spicydonkey/ecdl/bryce/ecdl-topview.pdf

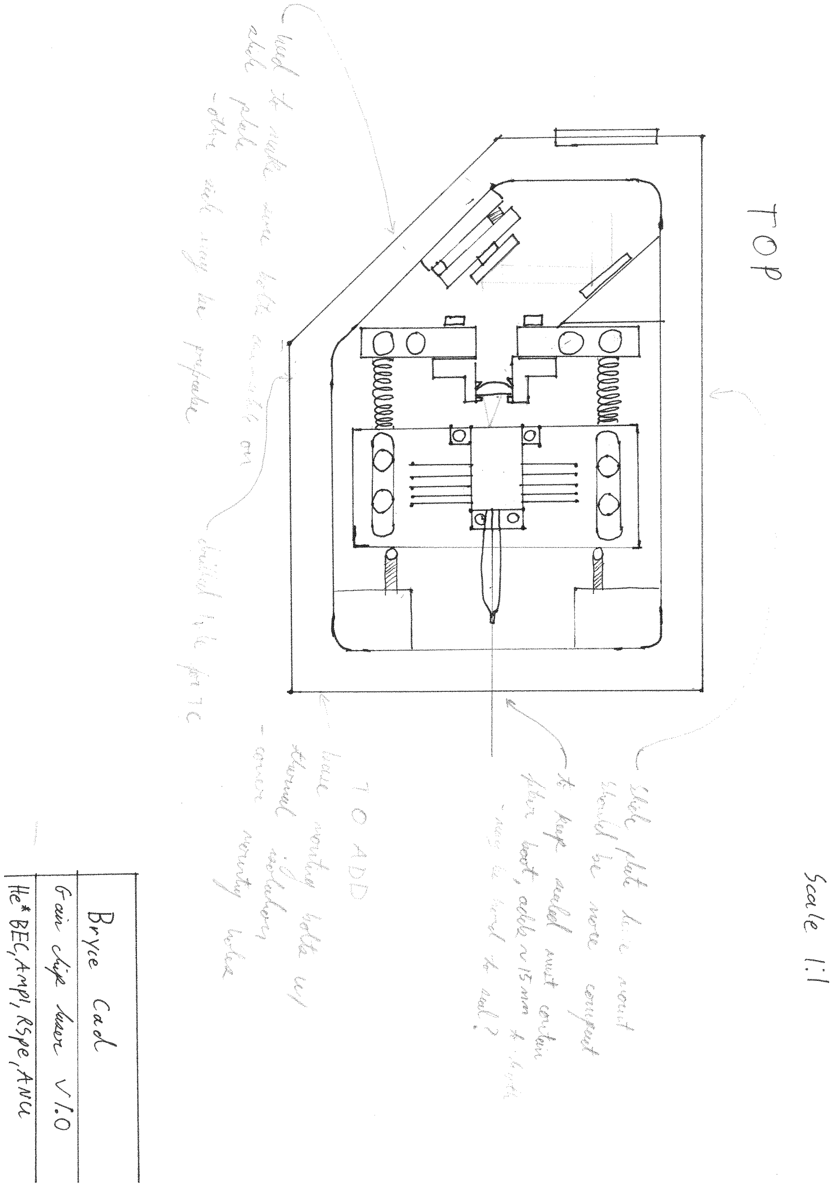
[picture p1: page 1]
