spicydonkey/ecdl/bryce/gc_mount.pdf

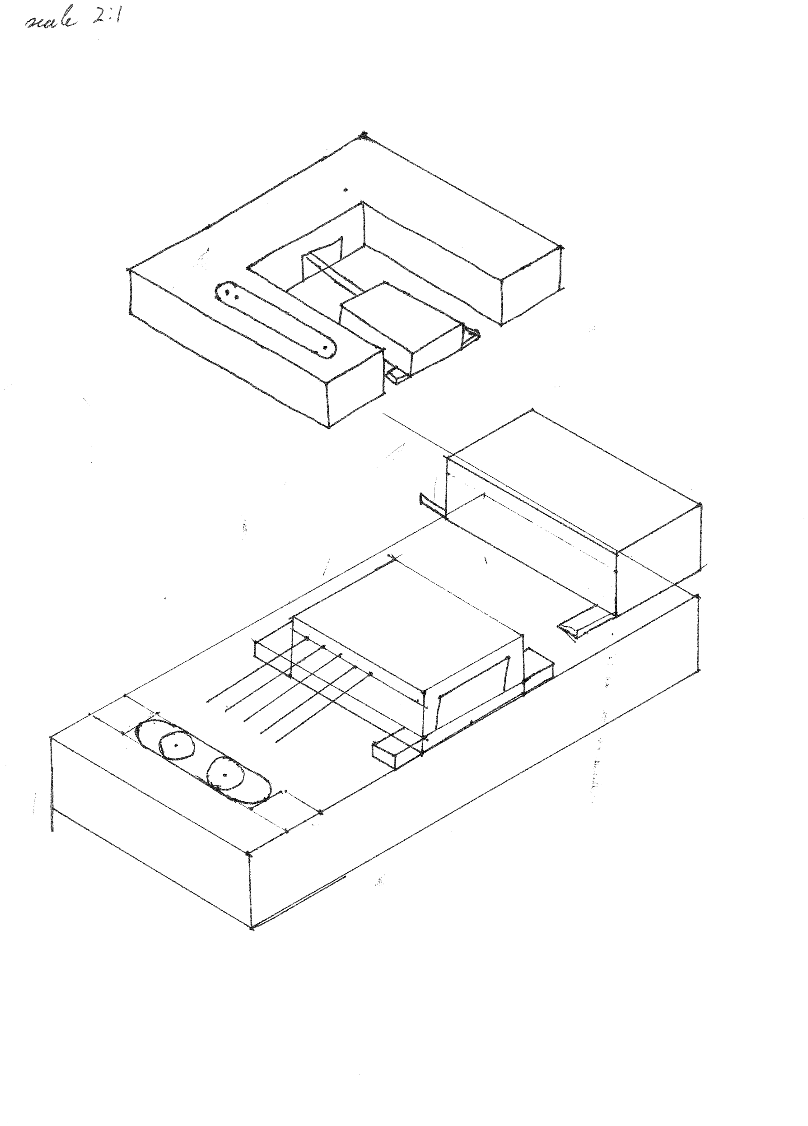
[picture p2: page 1]
