spicydonkey/ecdl/bryce/iso.pdf

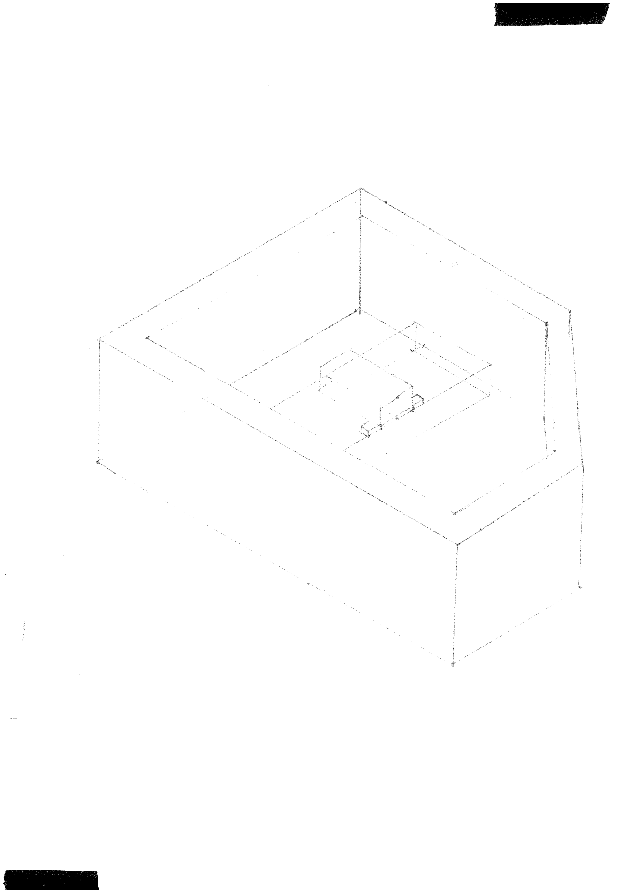
[picture p3: page 1]
