spicydonkey/ecdl/docs/bom.xlsx

Bill of Materials
Product code | Description | Supplier | Amount | Price
PISO-64-2-C-7-2-FB | Polarization maintaining isolator, 1064, dual, 3mm cable jacket, 0.75m fiber, slow axis working and fast axis blocked | AFW | 1 | 260 | 260
KMSS_M | Compact Kinematic Mirror Mount, Hex Adjuster, M4 Taps for Post Mounting | Thorlabs | 1 | 34.3 | 34.3
POLARIS-K05 | Polaris™ Low Drift Ø1/2" Mirror Mount, 3 Low-Profile Hex Adjusters | Thorlabs | 1 | 133 | 133
C240TME-1064 | f = 8.07 mm, NA = 0.5, Mounted Geltech Aspheric Lens, AR: 1064 nm | Thorlabs | 1 | 85.5 | 85.5
WW11050-C14 | Wedged N-BK7 Laser Window, 1dia, AR Coated: 1047 - 1064 nm | Thorlabs | 1 | 120 | 120
GR13-1210 | Ruled reflective diffraction grating, 1200/mm, 1um blaze, 12.7x12.7x6mm | Thorlabs | 1 | 65 | 65
PA4FK | 4 xPiezo chip, 150V, 3.6um, bare electrodes | Thorlabs | 2 | 31 | 62
PCh150/10x10/2 | 10x10x2mm piezo chip, >3um (bipolar) | Piezomechanik | 1 | 150 | 150
 | Lens accessory |  |  |  | 0
 | Fiber connectors |  |  |  | 0
 | Electrical connectors |  |  |  | 0
 |  |  |  |  | 0
 |  |  |  |  | 0
 |  |  |  | Total | 909.8
