spicydonkey/ecdl/B03/outsource/main_block_all.STEP

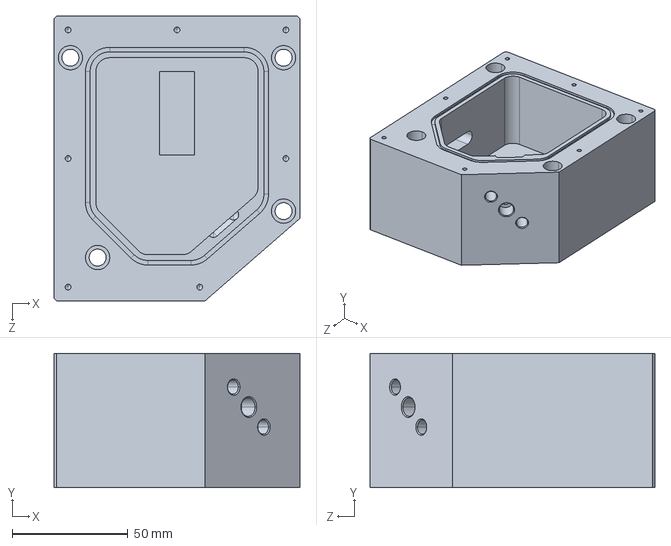
[picture p4: CAD file, 2015-10-12]
B03/outsource/main_block_all.STEP
106.0 x 58.0 x 123.0 mm
