spicydonkey/ecdl/B03/ecdl.SLDASM

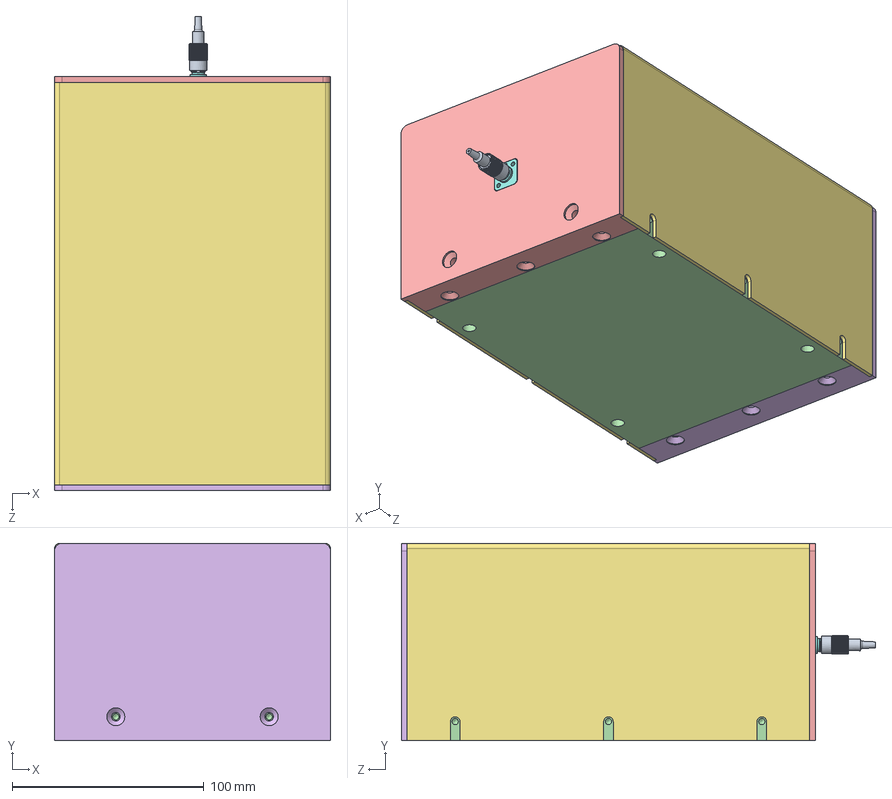
[picture p5: CAD file, 2015-10-22]
B03/ecdl.SLDASM
144.0 x 103.0 x 247.3 mm
ecdl_block
gainchip_mount
B03_KMSS_M-Solidworks_1_02
B03_GR13-1210-Solidworks_02
B03_PCh150-10x10-2
B03_WW11050-C14-Solidworks_02
B03_gainchip_02
fibre_cable_grip^ecdl
lens_tube^ecdl
B03_C240TME-1064-Solidworks
block lid^ecdl
base^ECDL casing_ecdl
front_wall^ECDL casing_ecdl
back_wall^ECDL casing_ecdl
folded_lid^ECDL casing_ecdl
ADAFCPM2-Solidworks
30080K1-Solidworks x 2
APH-127-10-25-S x 2
62GB-12E14-12PN(416)
62GB-56T14-12SN(416)_env
insulating mat^ecdl
fibre_storage_reel
FSRmount
