spicydonkey/ecdl/CAD/B03.SLDASM

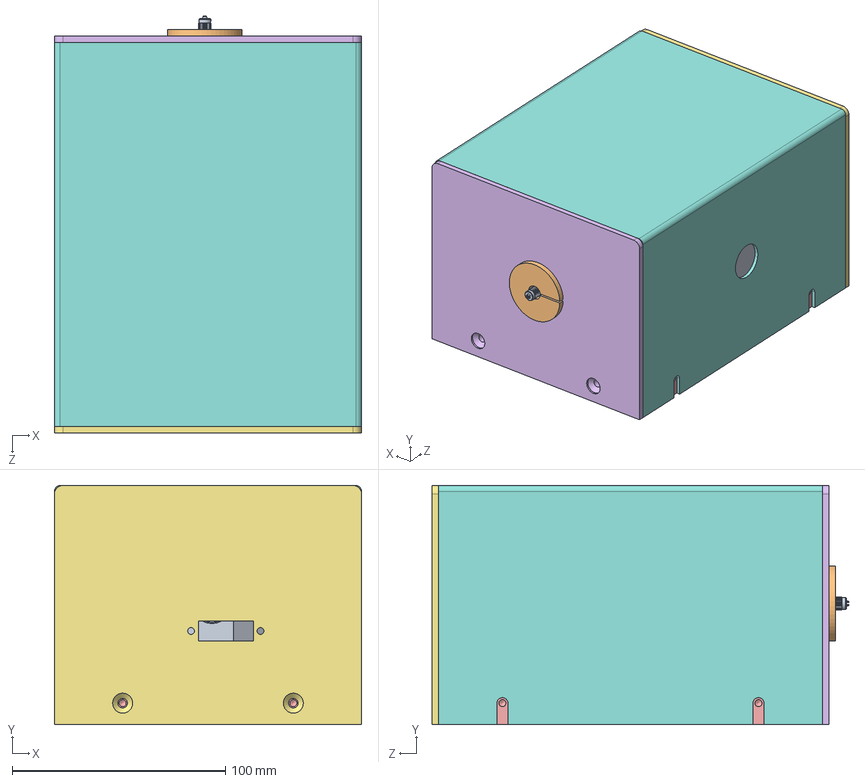
[picture p7: CAD file, 2015-09-30]
CAD/B03.SLDASM
144.0 x 112.0 x 195.4 mm
B03_B01_block_02
gainchip_mount^B03
B03_KMSS_M-Solidworks_1_02
B03_GR13-1210-Solidworks_02
B03_PCh150-10x10-2
B03_WW11050-C14-Solidworks_02
B03_gainchip_02
fibre_cable_grip^B03
lens_tube^B03
B03_C240TME-1064-Solidworks
TEC^B03
