spicydonkey/ecdl/CAD/B02.SLDASM

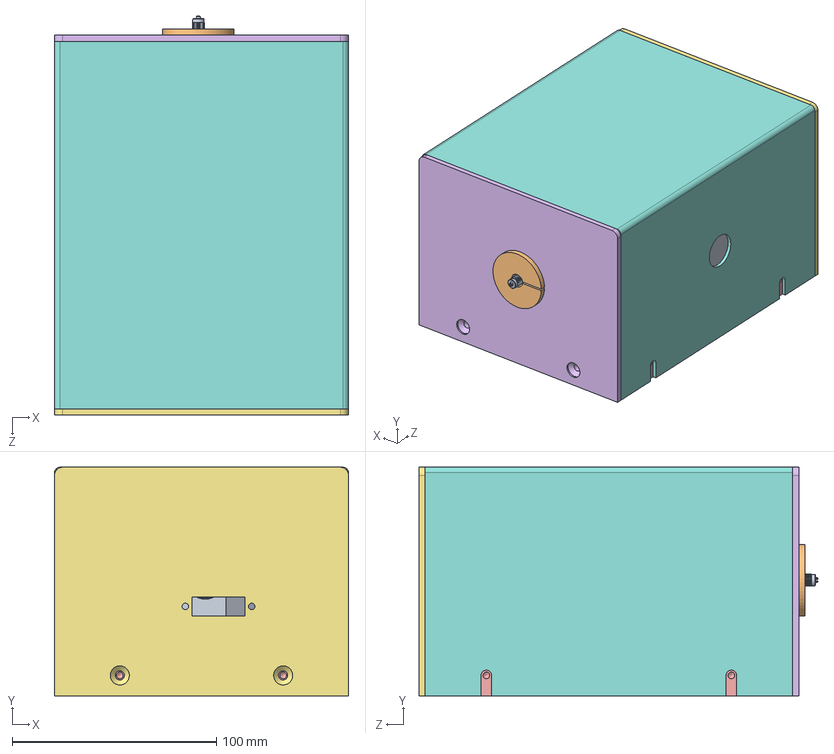
[picture p8: CAD file, 2015-09-29]
CAD/B02.SLDASM
144.0 x 112.0 x 195.4 mm
B01_block_02
B01_XY_bracket^B02
KMSS_M-Solidworks_1_02
GR13-1210-Solidworks_02
PCh150-10x10-2
WW11050-C14-Solidworks_02
gainchip_02
fibre_cable_grip^B02
lens_tube^B02
C240TME-1064-Solidworks
block lid^B02
