spicydonkey/ecdl/CAD/bare_fiber_chuck.SLDASM

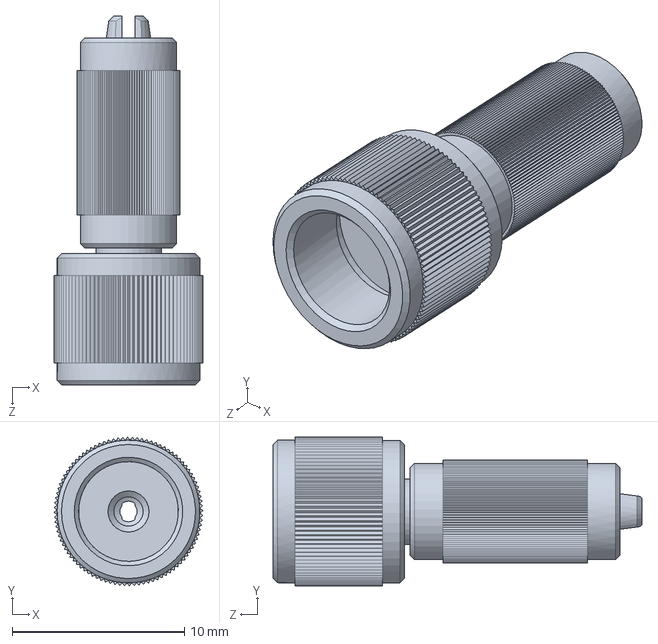
[picture p9: CAD file, 2015-09-28]
CAD/bare_fiber_chuck.SLDASM
8.64 x 8.64 x 21.4 mm
