spicydonkey/ecdl/CAD/grating_sub_02.SLDASM

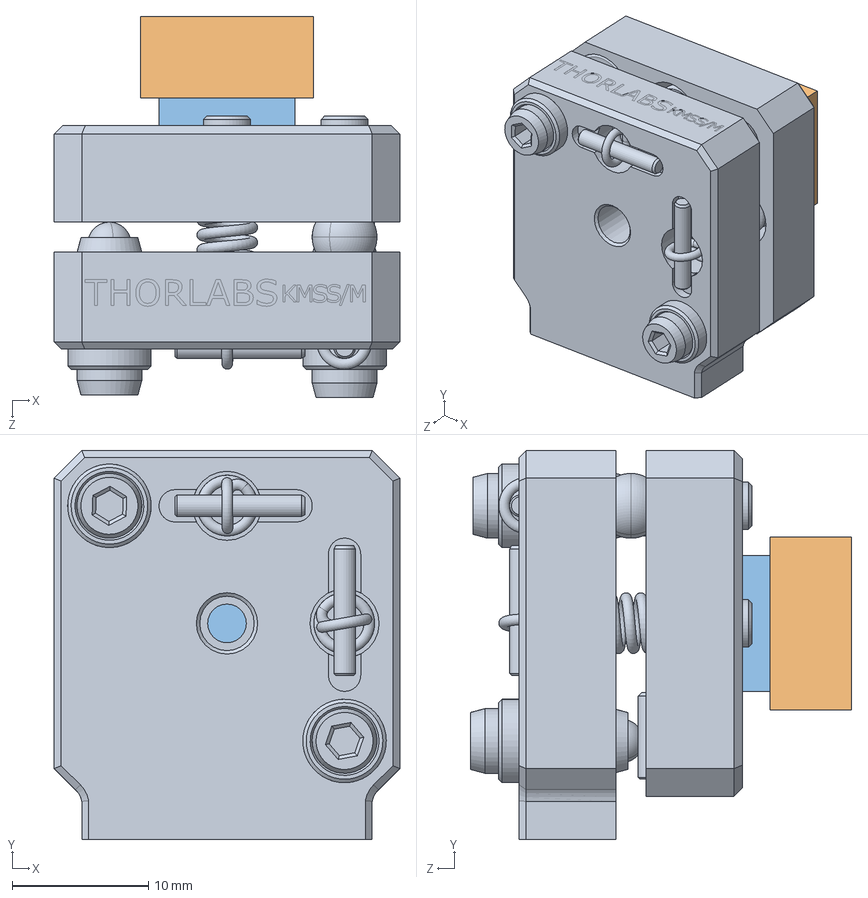
[picture p10: CAD file, 2015-09-26]
CAD/grating_sub_02.SLDASM
25.4 x 28.6 x 28.0 mm
KMSS_M-Solidworks_1_02
GR13-1210-Solidworks_02
PCh150-10x10-2
