spicydonkey/ecdl/CAD/B01_mock.SLDASM

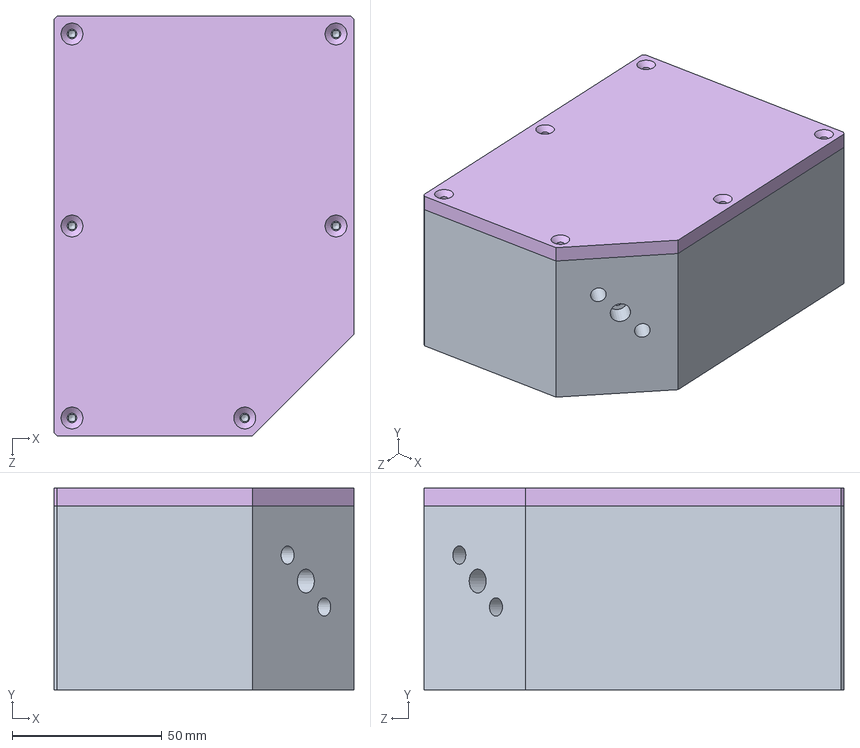
[picture p11: CAD file, 2015-09-25]
CAD/B01_mock.SLDASM
100.0 x 67.3 x 140.0 mm
B01_block
B01_gainchip_mount
gainchip
B01_slip_plate
lens_tube_05
B01_block_lid
KMSS_M-Solidworks_1
PA4FK-Solidworks
GR13-1210-Solidworks
B01_XY_bracket^B01_mock
WW11050-C14-Solidworks
