spicydonkey/ecdl/CAD/B01_gainchip.SLDASM

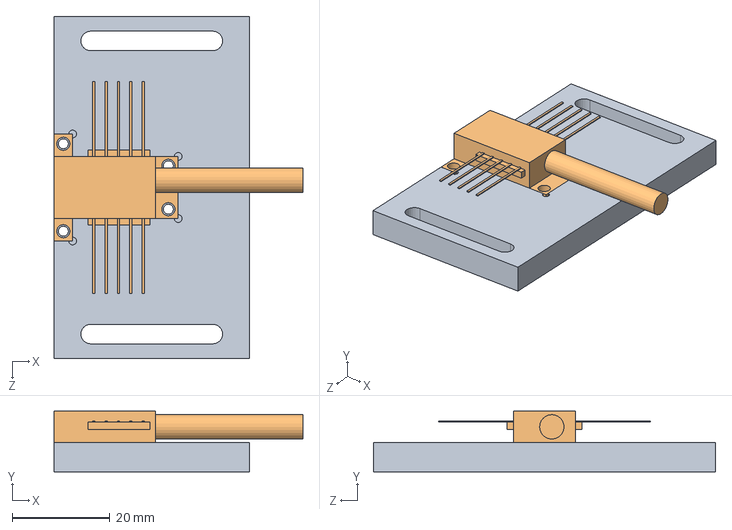
[picture p12: CAD file, 2015-09-25]
CAD/B01_gainchip.SLDASM
51.0 x 12.4 x 70.0 mm
B01_gainchip_mount
gainchip
