spicydonkey/ecdl/CAD/B01_lens_02.SLDASM

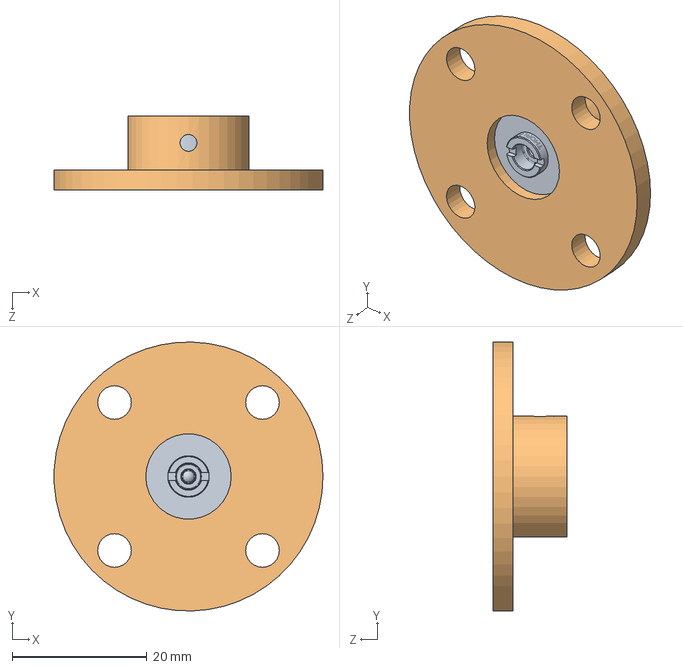
[picture p13: CAD file, 2015-09-24]
CAD/B01_lens_02.SLDASM
40.0 x 40.0 x 11.0 mm
B01_slip_plate_02
lens_tube_05_02
