spicydonkey/ecdl/CAD/B01_gainchip_02.SLDASM

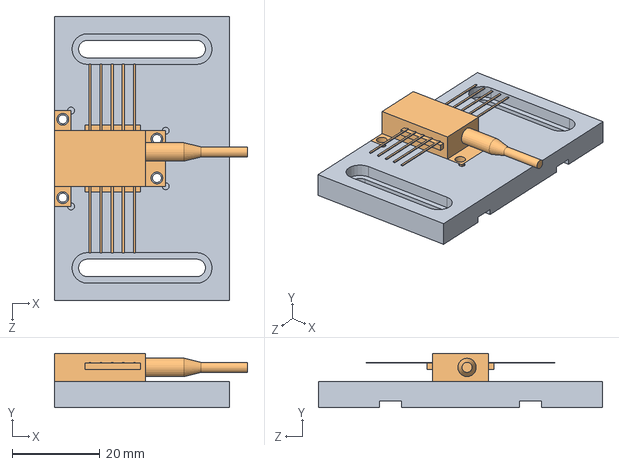
[picture p14: CAD file, 2015-09-24]
CAD/B01_gainchip_02.SLDASM
44.1 x 12.4 x 65.0 mm
B01_gainchip_mount_02
gainchip_02
