spicydonkey/ecdl/CAD/D02.SLDASM

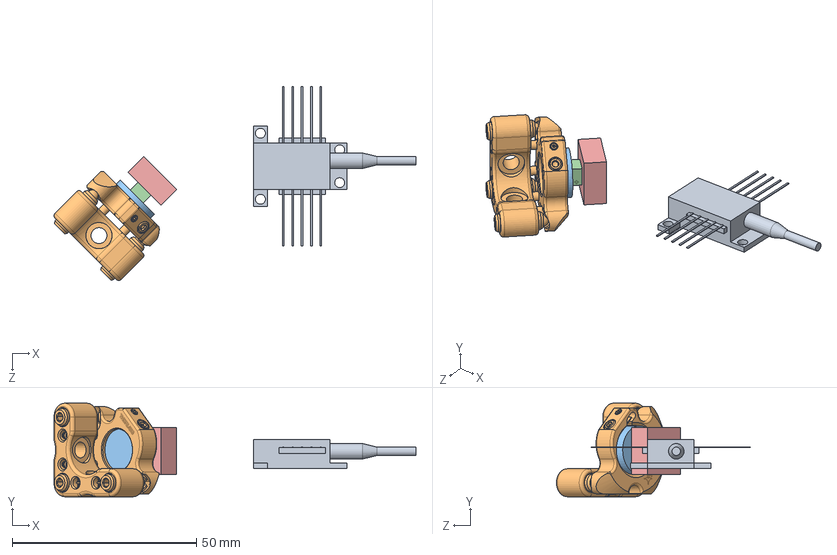
[picture p15: CAD file, 2015-09-21]
CAD/D02.SLDASM
98.2 x 25.4 x 52.7 mm
gainchip
POLARIS-K05-Solidworks
Part1^polaris_grating_sub
PA4FK-Solidworks
GR13-1210-Solidworks
