spicydonkey/ecdl/CAD/D01.SLDASM

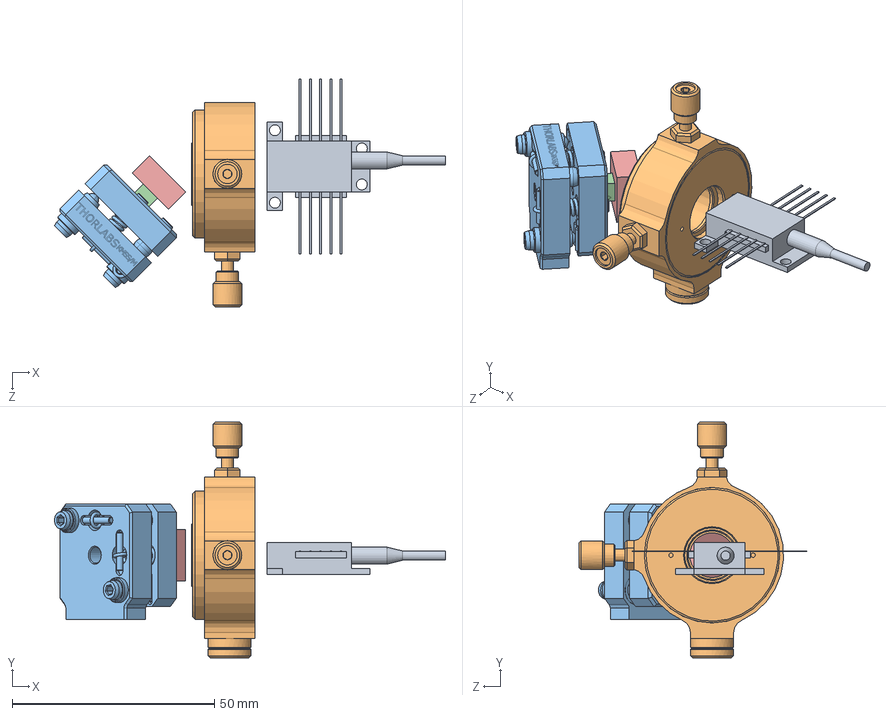
[picture p16: CAD file, 2015-09-21]
CAD/D01.SLDASM
96.7 x 58.3 x 56.4 mm
gainchip
LM05XY_M-Solidworks
KMSS_M-Solidworks_1
PA4FK-Solidworks
GR13-1210-Solidworks
