spicydonkey/ecdl/CAD/grating_sub.SLDASM

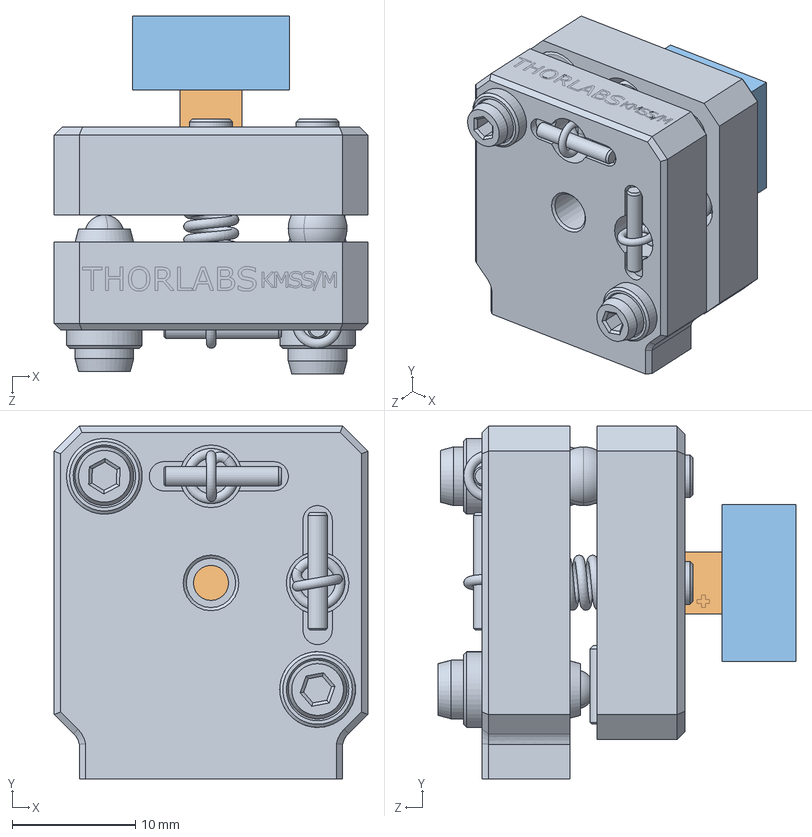
[picture p17: CAD file, 2015-09-21]
CAD/grating_sub.SLDASM
25.4 x 28.6 x 29.0 mm
KMSS_M-Solidworks_1
PA4FK-Solidworks
GR13-1210-Solidworks
