spicydonkey/ecdl/CAD/B01_lens_1.SLDASM

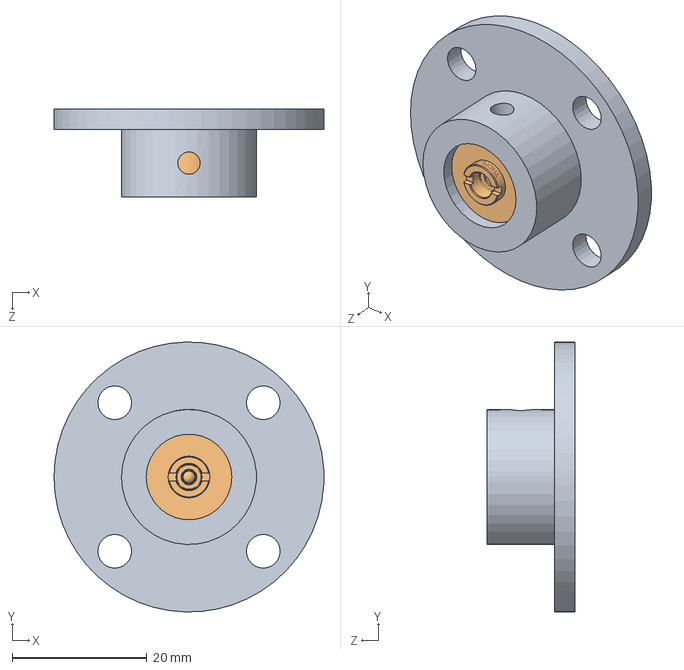
[picture p18: CAD file, 2015-09-14]
CAD/B01_lens_1.SLDASM
40.0 x 40.0 x 13.0 mm
B01_slip_plate_1
lens_tube_05_1
