spicydonkey/ecdl/CAD/B01_ecdl_1.SLDASM

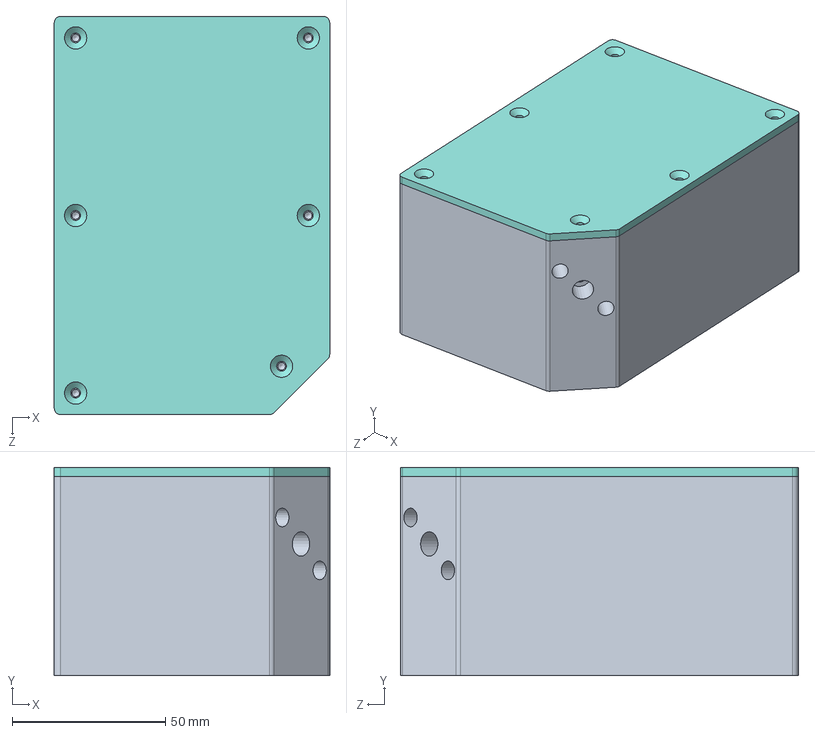
[picture p19: CAD file, 2015-09-14]
CAD/B01_ecdl_1.SLDASM
90.0 x 68.0 x 130.0 mm
B01_block_1
B01_gainchip_mount_1
gainchip_1
B01_slip_plate_1
lens_tube_05_1
B01_slip_mount_1
KMSS_M-Solidworks_1
