spicydonkey/ecdl/B03/FSRmount_flat.SLDPRT

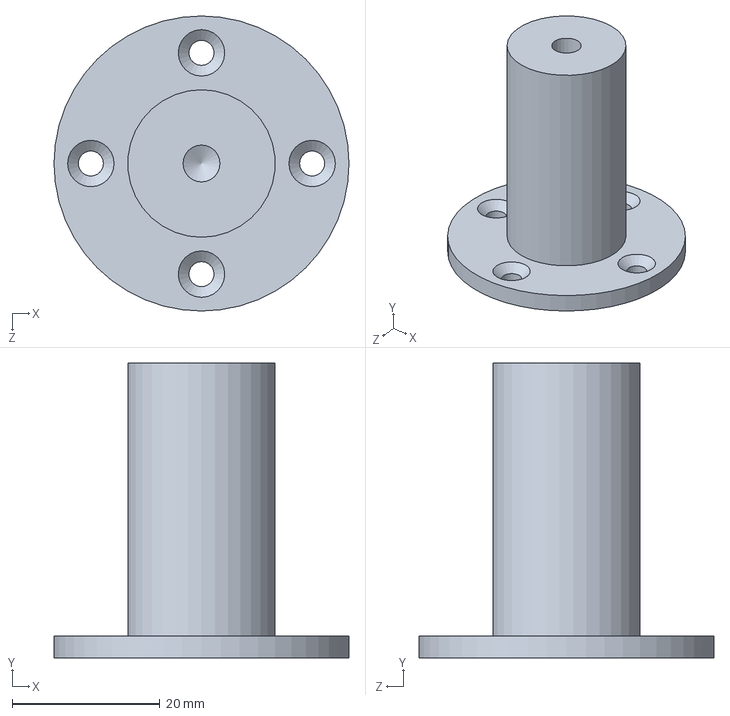
[picture p20: CAD file, 2015-10-22]
B03/FSRmount_flat.SLDPRT
40.0 x 40.0 x 40.0 mm
