spicydonkey/ecdl/B03/sent/gainchip_mount_sent.SLDPRT

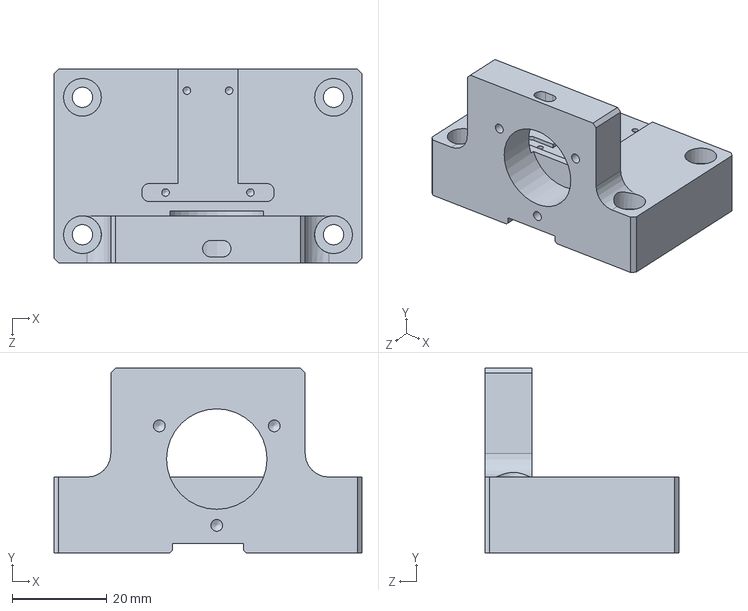
[picture p21: CAD file, 2015-10-22]
B03/sent/gainchip_mount_sent.SLDPRT
65.0 x 39.0 x 41.0 mm
