spicydonkey/ecdl/misc/62GB-56T14-12SN(416)_env.SLDPRT

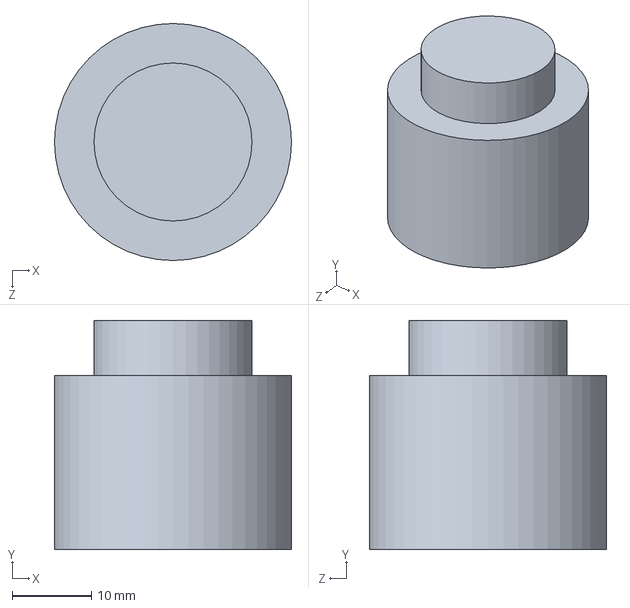
[picture p22: CAD file, 2015-10-20]
misc/62GB-56T14-12SN(416)_env.SLDPRT
30.0 x 29.0 x 30.0 mm
