spicydonkey/ecdl/CAD/B03_B01_block_02.SLDPRT

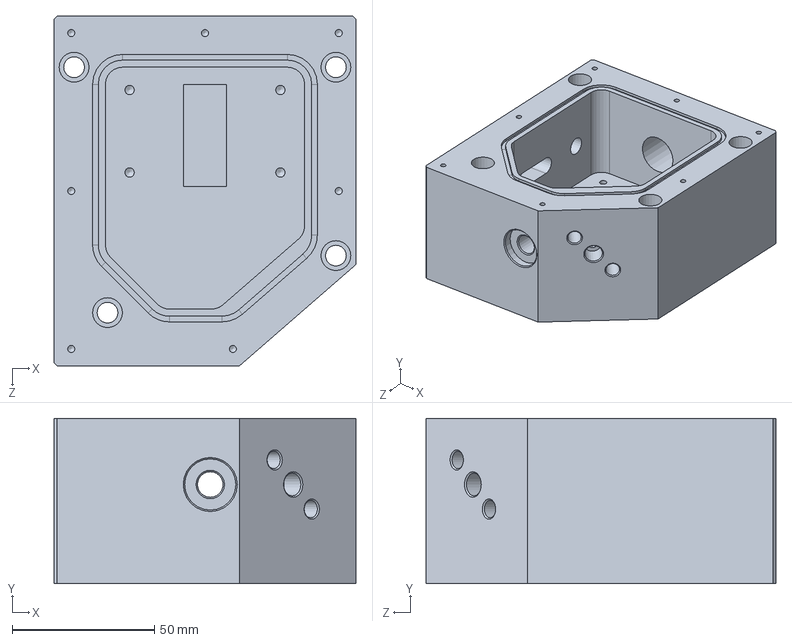
[picture p23: CAD file, 2015-10-02]
CAD/B03_B01_block_02.SLDPRT
106.0 x 58.0 x 123.0 mm
