spicydonkey/ecdl/misc/APH-127-10-25-S.SLDPRT

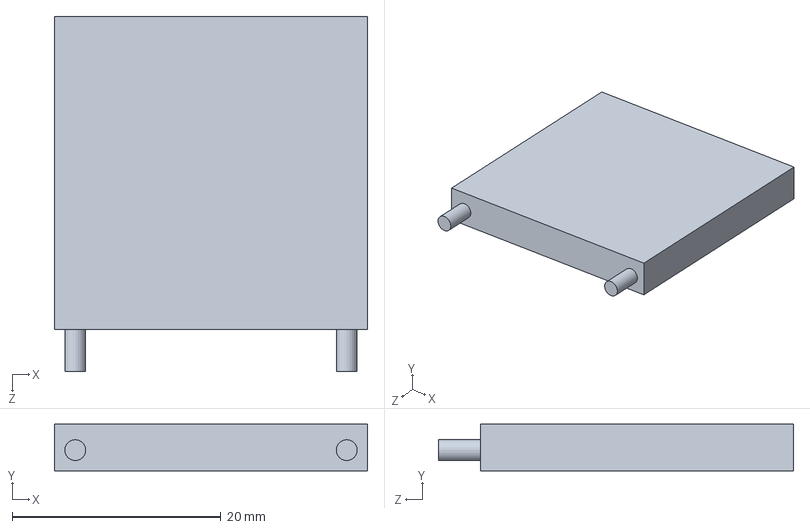
[picture p24: CAD file, 2015-10-13]
misc/APH-127-10-25-S.SLDPRT
30.0 x 4.50 x 34.0 mm
