spicydonkey/ecdl/B03/fibre_storage_reel.SLDPRT

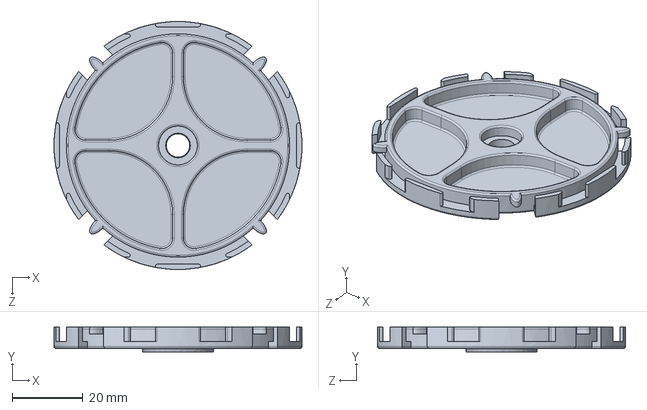
[picture p25: CAD file, 2015-10-22]
B03/fibre_storage_reel.SLDPRT
70.0 x 7.00 x 70.0 mm
