spicydonkey/ecdl/misc/APH-127-10-20-S.SLDPRT

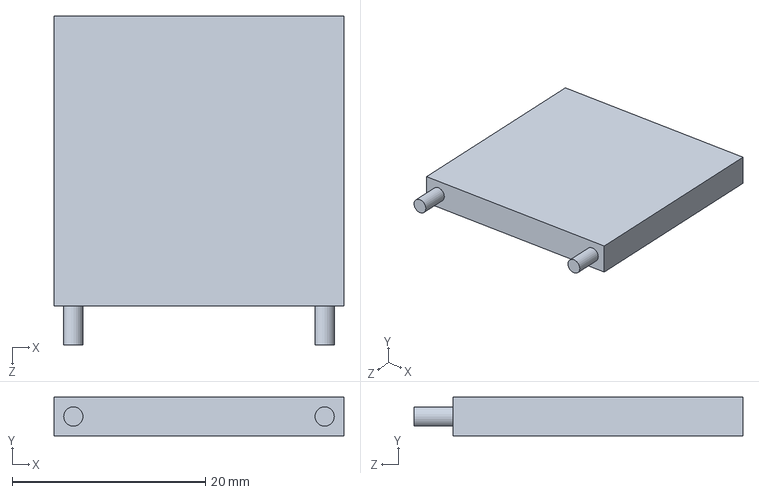
[picture p26: CAD file, 2015-10-13]
misc/APH-127-10-20-S.SLDPRT
30.0 x 4.00 x 34.0 mm
