spicydonkey/ecdl/B03/FSRmount.SLDPRT

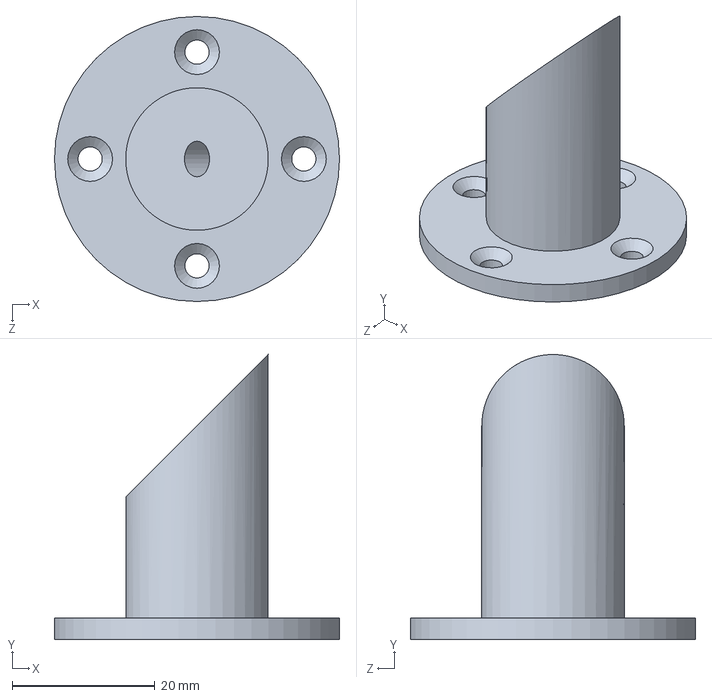
[picture p27: CAD file, 2015-10-22]
B03/FSRmount.SLDPRT
40.0 x 40.0 x 40.0 mm
