spicydonkey/ecdl/CAD/B01_block_02.SLDPRT

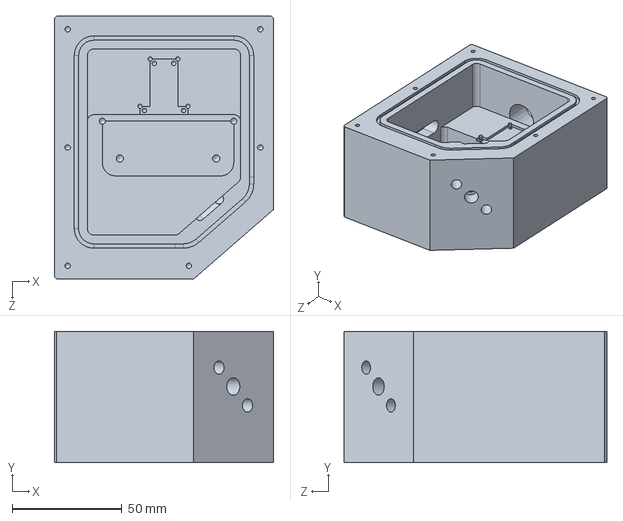
[picture p28: CAD file, 2015-09-29]
CAD/B01_block_02.SLDPRT
100.0 x 60.0 x 120.0 mm
