spicydonkey/ecdl/misc/62GB-12E14-12PN(416).SLDPRT

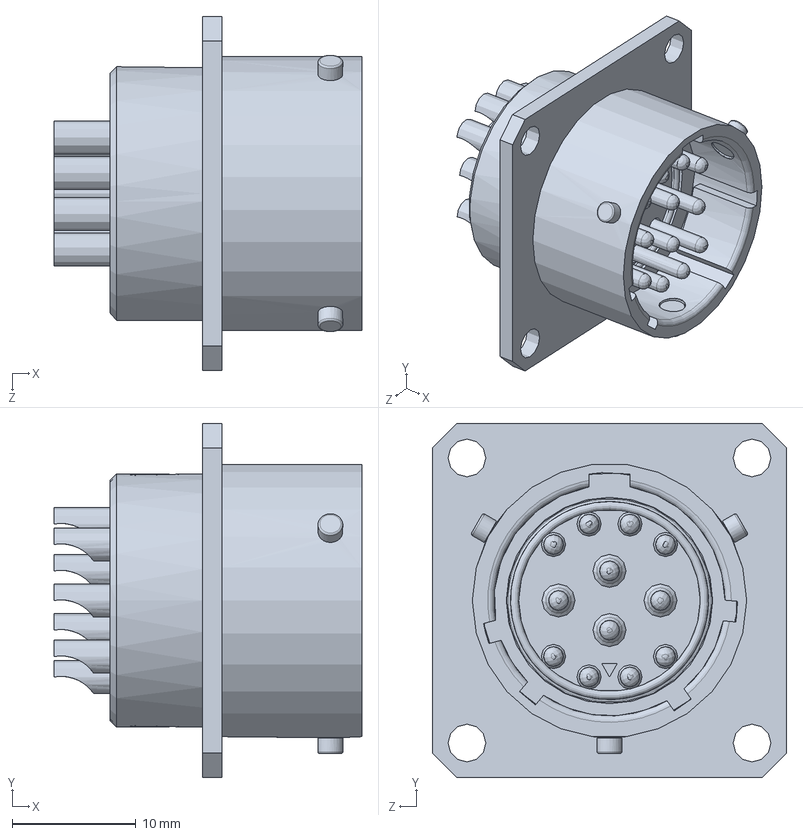
[picture p29: CAD file, 2015-10-13]
misc/62GB-12E14-12PN(416).SLDPRT
24.8 x 28.6 x 28.6 mm
