spicydonkey/ecdl/B03/fibre_cable_grip^ecdl.sldprt

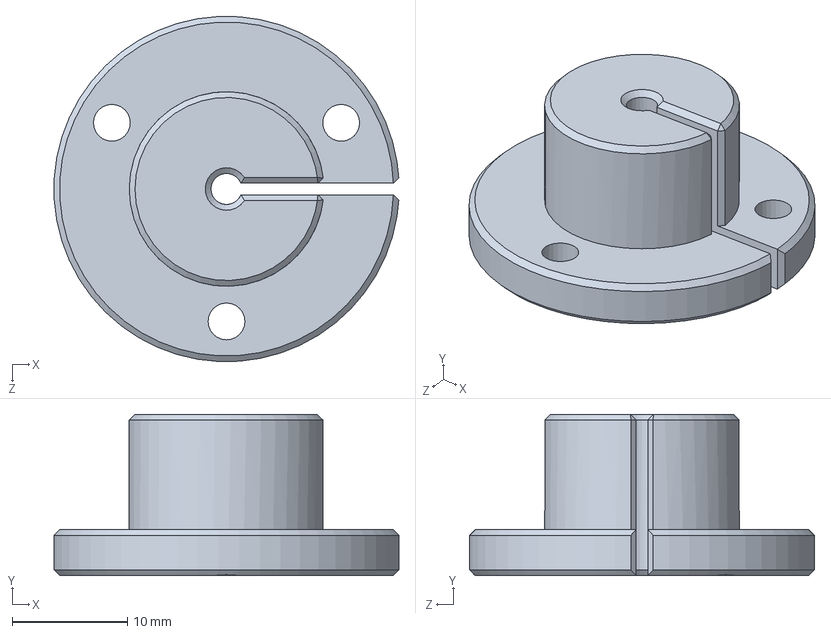
[picture p30: CAD file, 2015-10-21]
B03/fibre_cable_grip^ecdl.sldprt
29.9 x 14.0 x 30.0 mm
