spicydonkey/ecdl/B03/ecdl_block.SLDPRT

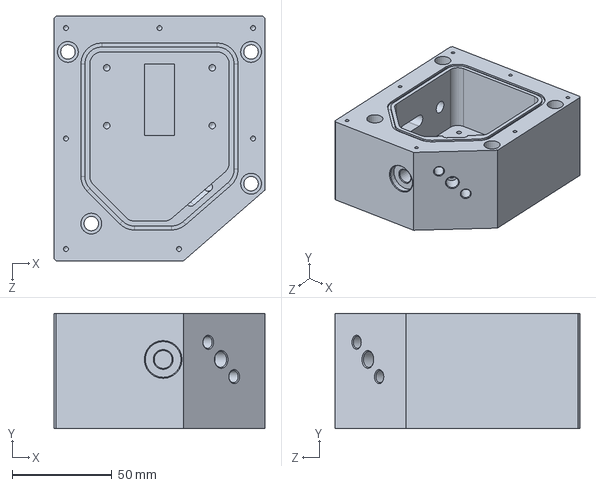
[picture p31: CAD file, 2015-10-21]
B03/ecdl_block.SLDPRT
106.0 x 58.0 x 123.0 mm
