spicydonkey/ecdl/CAD/B03_PCh150-10x10-2.SLDPRT

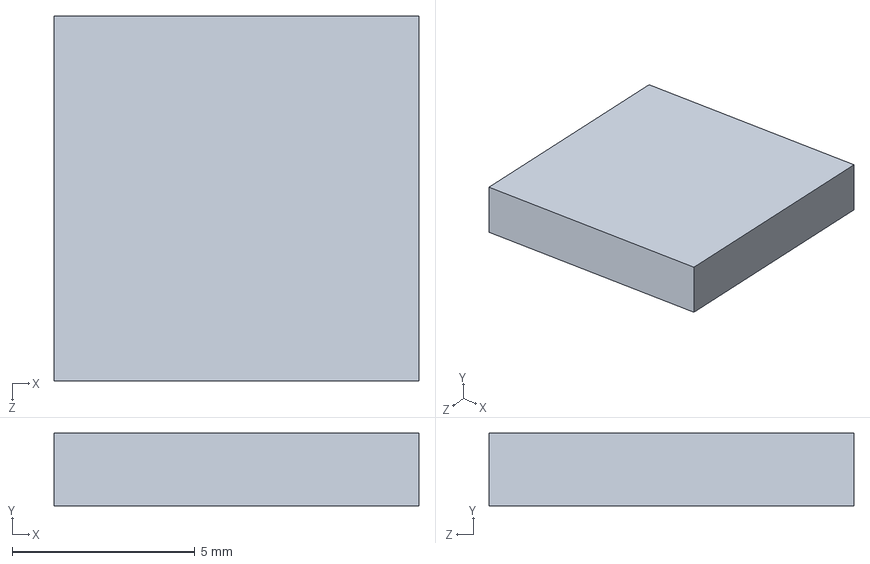
[picture p32: CAD file, 2015-09-28]
CAD/B03_PCh150-10x10-2.SLDPRT
10.0 x 2.00 x 10.0 mm
