spicydonkey/ecdl/misc/62GB-12E14-19PN.SLDPRT

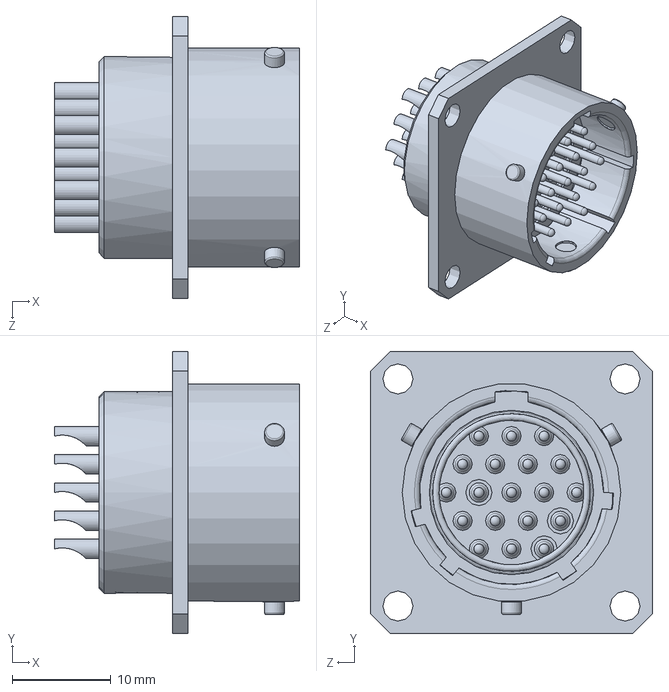
[picture p33: CAD file, 2015-10-13]
misc/62GB-12E14-19PN.SLDPRT
24.8 x 28.6 x 28.6 mm
