spicydonkey/ecdl/B03/block lid^ecdl.sldprt

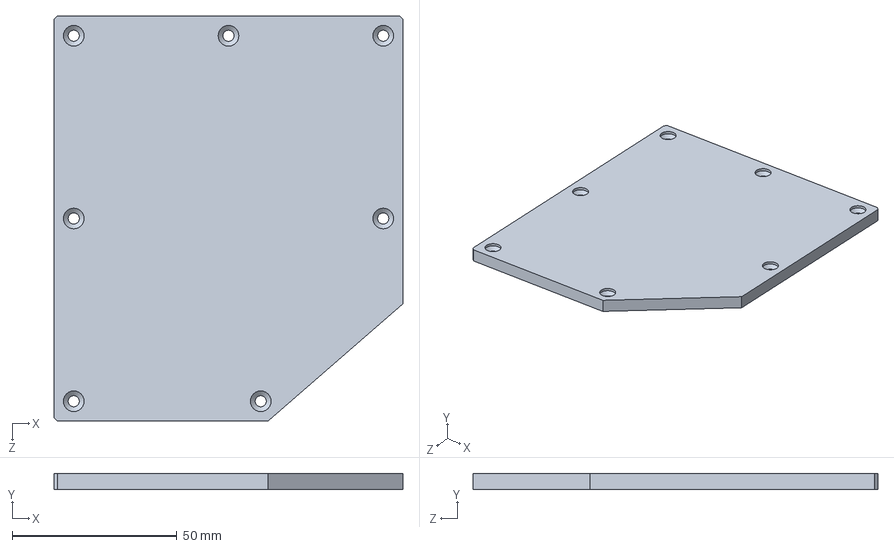
[picture p34: CAD file, 2015-10-01]
B03/block lid^ecdl.sldprt
106.0 x 5.00 x 123.0 mm
