spicydonkey/ecdl/CAD/B03_gainchip_02.SLDPRT

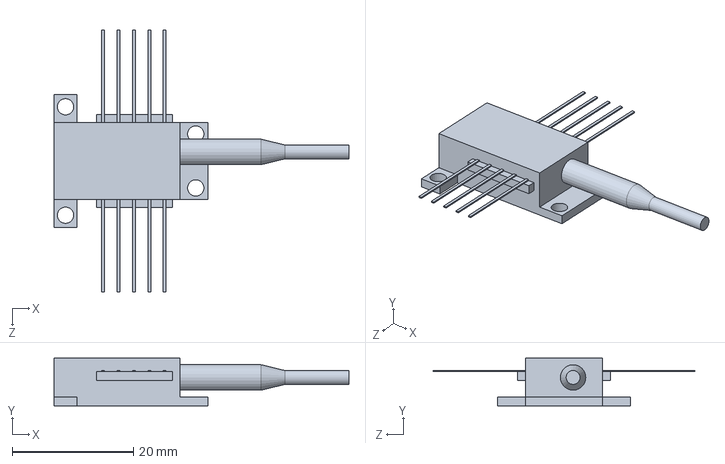
[picture p35: CAD file, 2015-09-28]
CAD/B03_gainchip_02.SLDPRT
48.7 x 7.90 x 43.3 mm
