spicydonkey/ecdl/B03/lens_tube^ecdl.sldprt

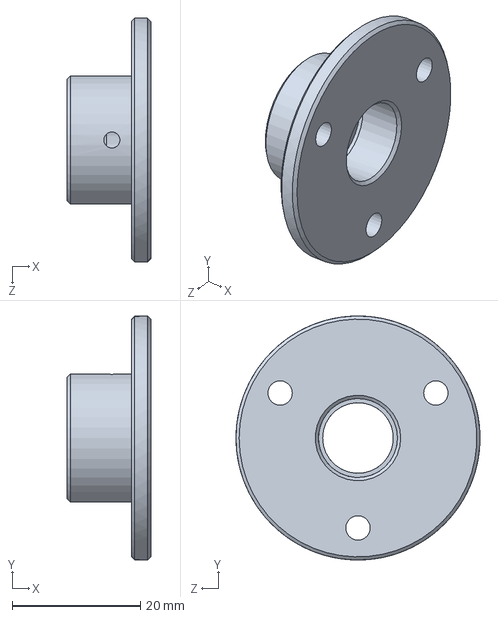
[picture p36: CAD file, 2015-09-30]
B03/lens_tube^ecdl.sldprt
13.0 x 38.0 x 38.0 mm
