spicydonkey/ecdl/CAD/B01_block_lid_02.SLDPRT

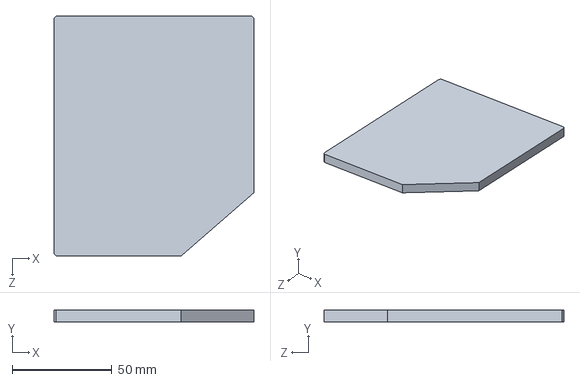
[picture p37: CAD file, 2015-09-26]
CAD/B01_block_lid_02.SLDPRT
100.0 x 6.00 x 120.0 mm
