spicydonkey/ecdl/CAD/B01_gainchip_mount.SLDPRT

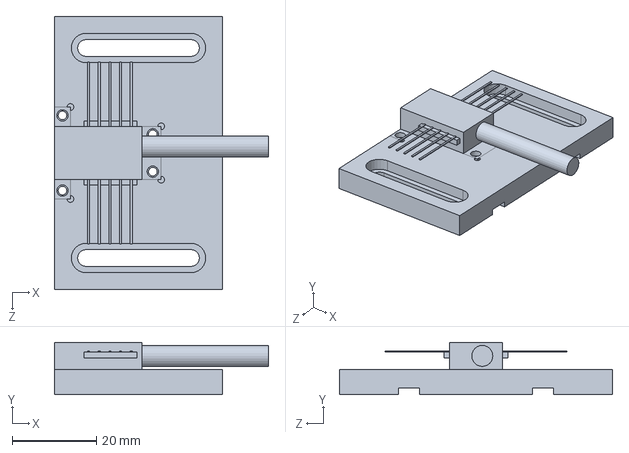
[picture p38: CAD file, 2015-09-25]
CAD/B01_gainchip_mount.SLDPRT
51.0 x 12.4 x 65.0 mm
