spicydonkey/ecdl/CAD/B01_slip_plate_02.SLDPRT

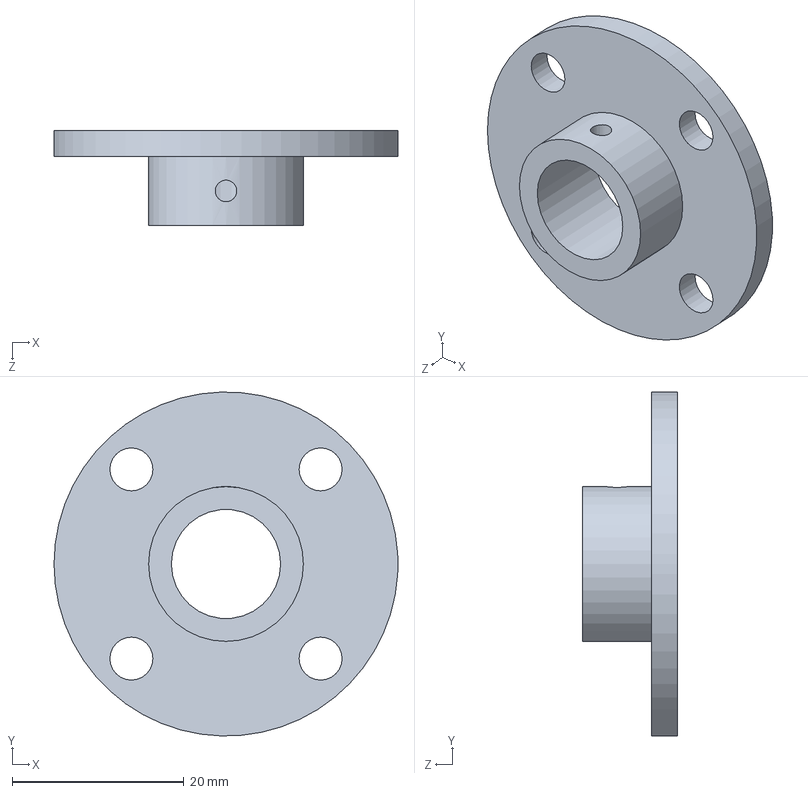
[picture p39: CAD file, 2015-09-24]
CAD/B01_slip_plate_02.SLDPRT
40.0 x 40.0 x 11.0 mm
