spicydonkey/ecdl/CAD/lens_tube_05_02.SLDPRT

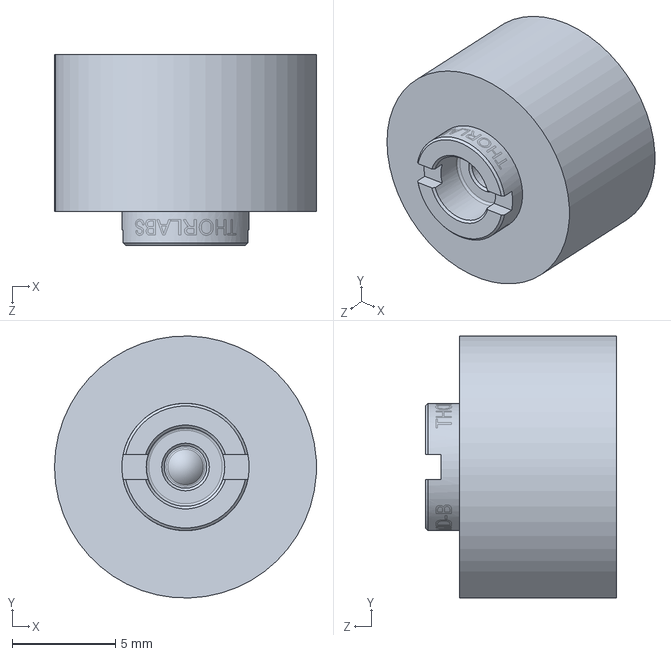
[picture p40: CAD file, 2015-09-24]
CAD/lens_tube_05_02.SLDPRT
12.7 x 12.7 x 9.27 mm
