spicydonkey/ecdl/CAD/B01_block.SLDPRT

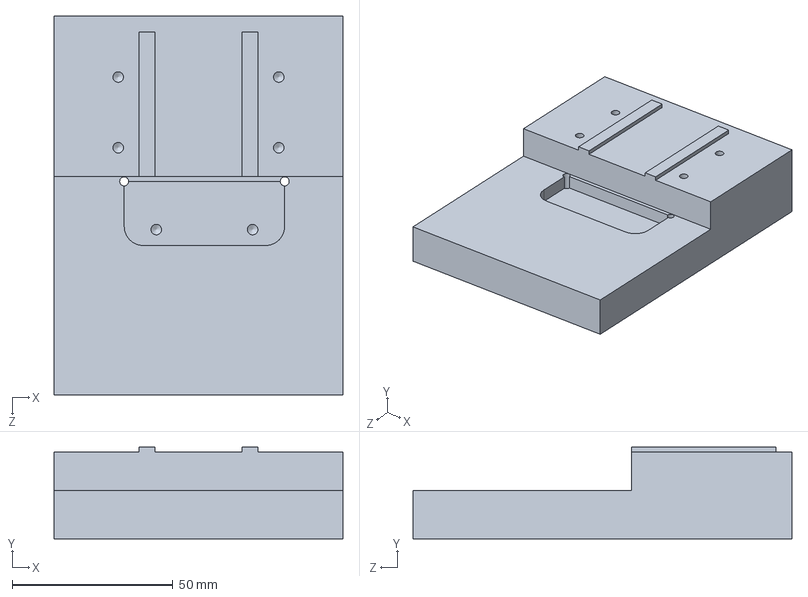
[picture p41: CAD file, 2015-09-21]
CAD/B01_block.SLDPRT
90.0 x 28.5 x 118.0 mm
