spicydonkey/ecdl/CAD/B01_block_lid.SLDPRT

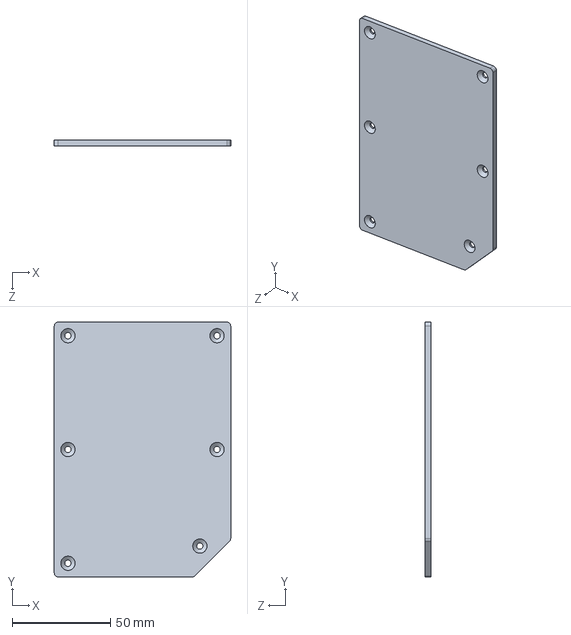
[picture p42: CAD file, 2015-09-18]
CAD/B01_block_lid.SLDPRT
90.0 x 130.0 x 3.00 mm
