spicydonkey/ecdl/CAD/B01_block_ref.SLDPRT

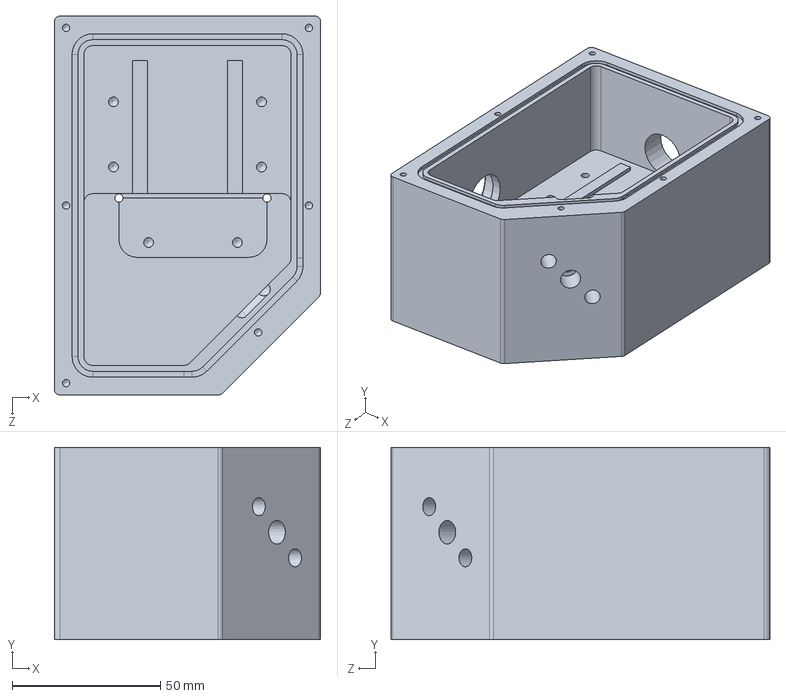
[picture p43: CAD file, 2015-09-18]
CAD/B01_block_ref.SLDPRT
90.0 x 65.0 x 128.0 mm
