spicydonkey/ecdl/CAD/B01_block_fix.SLDPRT

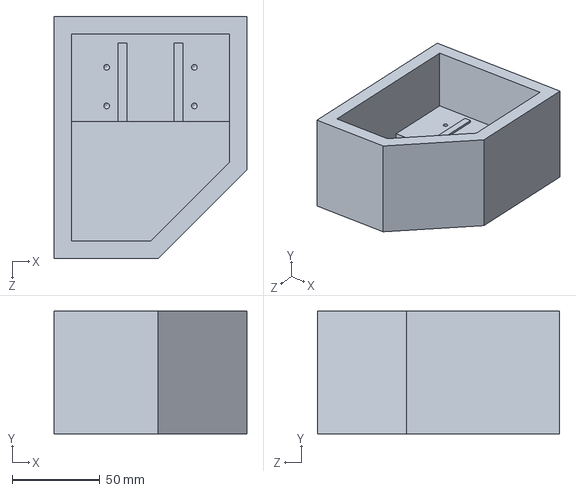
[picture p44: CAD file, 2015-09-18]
CAD/B01_block_fix.SLDPRT
110.0 x 70.0 x 138.0 mm
