spicydonkey/ecdl/CAD/B01_slip_mount.SLDPRT

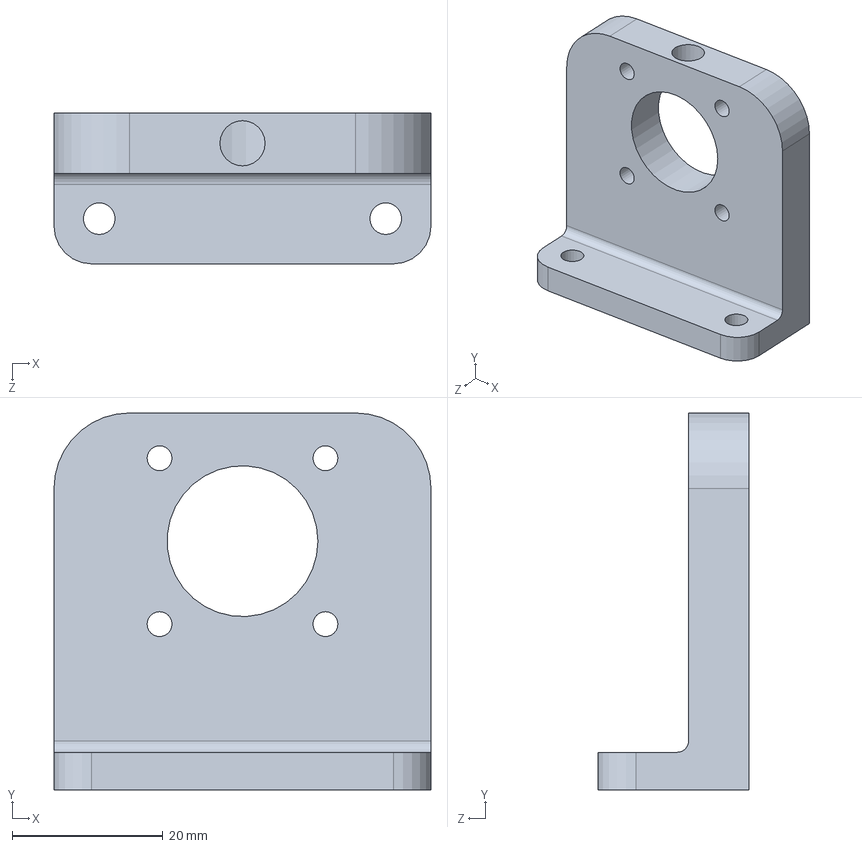
[picture p45: CAD file, 2015-09-16]
CAD/B01_slip_mount.SLDPRT
50.0 x 50.0 x 20.0 mm
