spicydonkey/ecdl/CAD/B01_slip_mount_1.SLDPRT

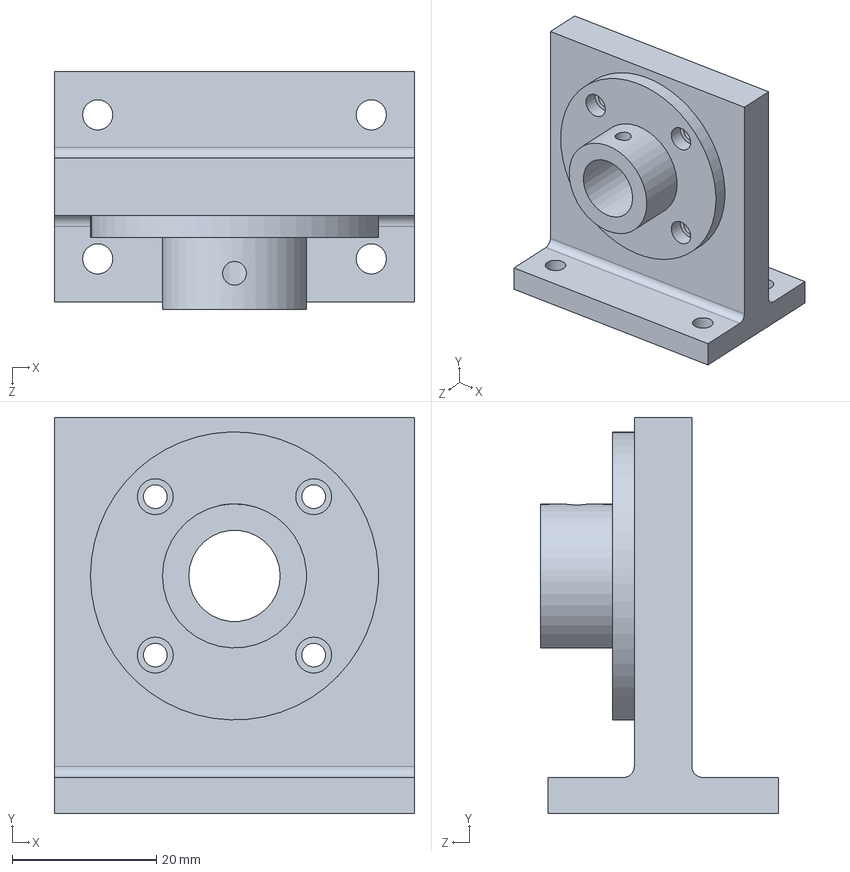
[picture p46: CAD file, 2015-09-14]
CAD/B01_slip_mount_1.SLDPRT
50.0 x 55.0 x 33.0 mm
