spicydonkey/ecdl/CAD/gainchip_1.SLDPRT

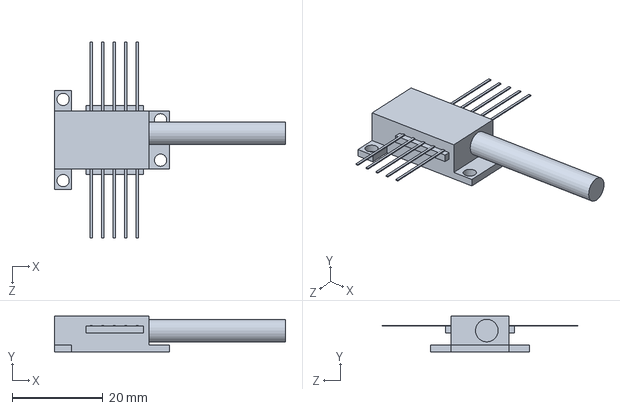
[picture p47: CAD file, 2015-09-14]
CAD/gainchip_1.SLDPRT
51.0 x 7.90 x 43.3 mm
