spicydonkey/ecdl/CAD/B01_slip_plate_1.SLDPRT

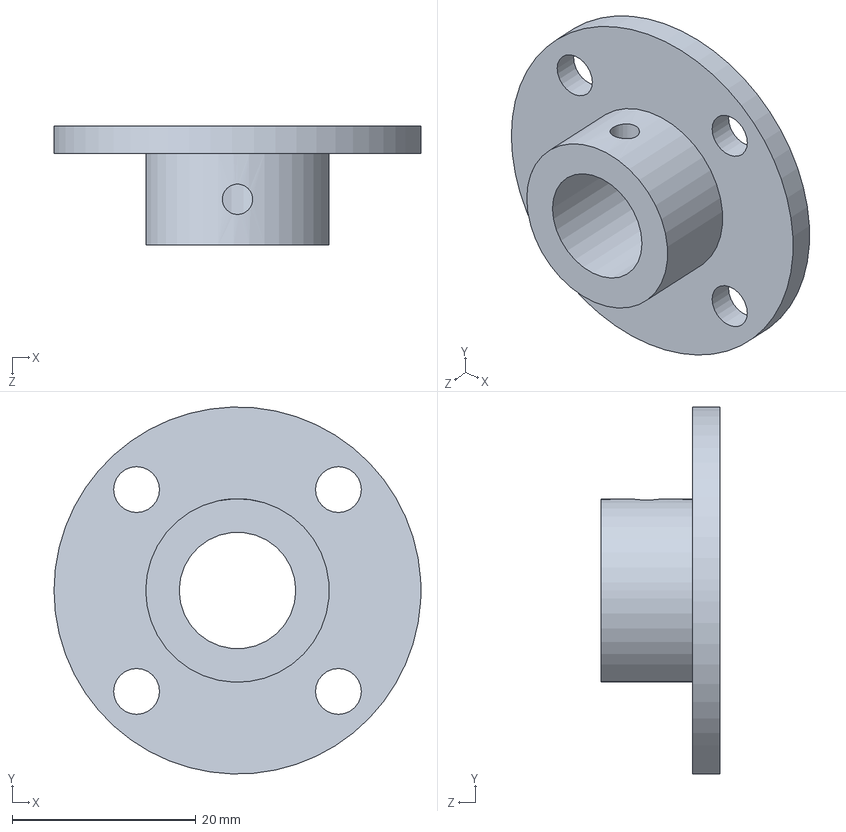
[picture p48: CAD file, 2015-09-14]
CAD/B01_slip_plate_1.SLDPRT
40.0 x 40.0 x 13.0 mm
