spicydonkey/ecdl/CAD/B01_block_1.SLDPRT

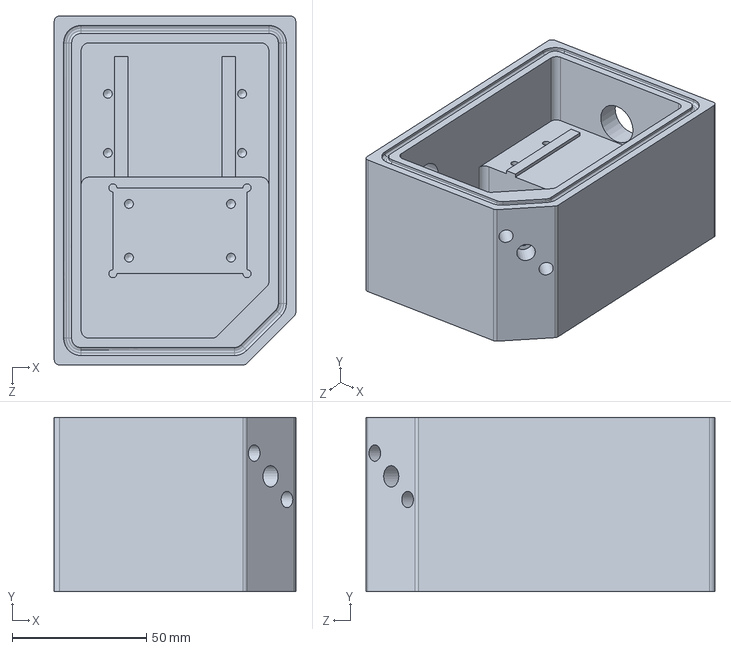
[picture p49: CAD file, 2015-09-14]
CAD/B01_block_1.SLDPRT
90.0 x 65.0 x 130.0 mm
