spicydonkey/ecdl/CAD/B03_grating_sub_02.SLDASM

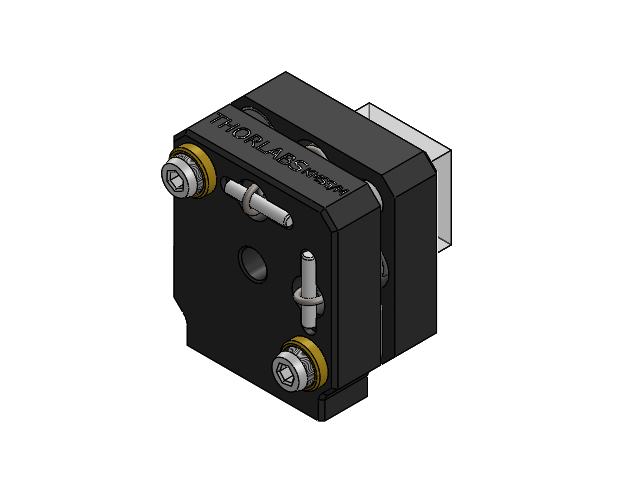
[picture p50: CAD file, 2015-10-22]
CAD/B03_grating_sub_02.SLDASM
B03_KMSS_M-Solidworks_1_02
B03_GR13-1210-Solidworks_02
B03_PCh150-10x10-2
