spicydonkey/ecdl/(list of files, cad)

Other CAD files:
CAD/B01_lens.SLDASM
CAD/B01_gainchip_1.SLDASM
B03/sent/ecdl_block_rev.STEP
B03/sent/ecdl_block_sent.STEP
misc/62GB-12E14-12PN.SLDPRT
B03/gainchip_mount.SLDPRT
CAD/PCh150-10x10-2.SLDPRT
CAD/gainchip_02.SLDPRT
CAD/gainchip.SLDPRT
CAD/B01_gainchip_mount_02.SLDPRT
CAD/B01_slip_plate.SLDPRT
CAD/B01_block_lid_1.SLDPRT
CAD/lens_tube_05_1.SLDPRT
CAD/B01_gainchip_mount_1.SLDPRT
CAD/lens_tube_05.SLDPRT
B03/B03_B01_block_02.SLDDRW
B03/FSRmount.SLDDRW
B03/block_lid.SLDDRW
B03/ecdl_block.SLDDRW
B03/fibre_cable_grip^ecdl.SLDDRW
B03/fibre_storage_reel.STL
B03/gainchip_mount.SLDDRW
B03/lens_tube^ecdl.SLDDRW
B03/outsource/main_block.SLDPRT
B03/outsource/main_block_all.SLDPRT
B03/sent/ecdl_block_rev.SLDPRT
B03/sent/ecdl_block_sent.SLDPRT
CAD/OldVersions/polaris_K05.0007.iam
CAD/OldVersions/polaris_K05_front.0006.ipt
CAD/OldVersions/polaris_K05_main.0009.ipt
CAD/OldVersions/polaris_K05_screw.0002.ipt
CAD/inventor/gainchip.ipt
CAD/inventor/polaris_K05.iam
CAD/inventor/polaris_K05.ipt
CAD/inventor/polaris_K05_front.ipt
CAD/inventor/polaris_K05_main.ipt
CAD/inventor/polaris_K05_screw.ipt
Thorlabs/30080K1-Solidworks.sldprt
Thorlabs/AD1109F-Solidworks.sldprt
Thorlabs/ADAFCPM2-Solidworks.sldprt
Thorlabs/B03_C240TME-1064-Solidworks.sldprt
Thorlabs/B03_GR13-1210-Solidworks_02.sldprt
Thorlabs/B03_KMSS_M-Solidworks_1_02.SLDPRT
Thorlabs/B03_WW11050-C14-Solidworks_02.sldprt
Thorlabs/C140TMD-B-Solidworks.sldprt
Thorlabs/C230TME-1064-Solidworks.sldprt
Thorlabs/C240TME-1064-Solidworks.sldprt
Thorlabs/FPH-SR.SLDPRT
Thorlabs/FSR1-Solidworks.sldprt
Thorlabs/GR13-1210-Solidworks.sldprt
Thorlabs/GR13-1210-Solidworks_02.sldprt
Thorlabs/KMSS_M-Solidworks.SLDPRT
Thorlabs/KMSS_M-Solidworks_1.SLDPRT
Thorlabs/KMSS_M-Solidworks_1_02.SLDPRT
Thorlabs/LM05XY_M-Solidworks.sldprt
Thorlabs/LM1XY_M-Solidworks.sldprt
Thorlabs/PA4FK-Solidworks.sldprt
Thorlabs/PA4FK-Solidworks_02.sldprt
Thorlabs/PA4FKW-Solidworks.sldprt
Thorlabs/POLARIS-K05-Solidworks.sldprt
Thorlabs/POLARIS-K1-H-Solidworks.sldprt
Thorlabs/WW11050-C13-Solidworks.sldprt
Thorlabs/WW11050-C14-Solidworks.sldprt
Thorlabs/WW11050-C14-Solidworks_02.sldprt
Thorlabs/polaris_grating_sub.SLDASM
