spicydonkey/ecdl/B03/fibre_cable_grip_rev2.PDF

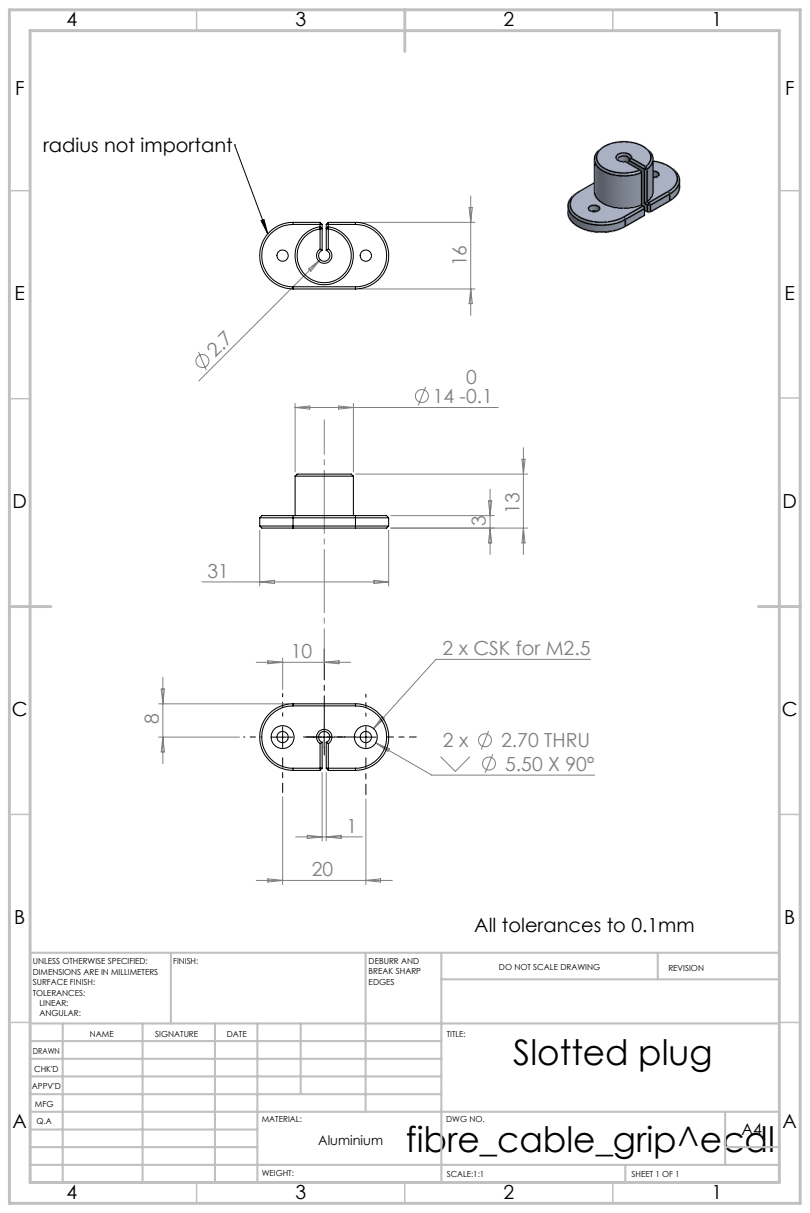
[picture p51: page 1]
2 x CSK for M2.5; 2.70 THRU; FINISH:; DEBURR AND; BREAK SHARP; DO NOT SCALE DRAWING; REVISION; SCALE:1:1; SHEET 1 OF 1

radius not important

All tolerances to 0.1mm

UNLESS OTHERWISE SPECIFIED:
DIMENSIONS ARE IN MILLIMETERS
SURFACE FINISH:
TOLERANCES:
LINEAR:
ANGULAR:

NAME | SIGNATURE | DATE | | | | TITLE: Slotted plug

DRAWN
CHK'D
APPV'D
MFG
Q.A | | | | MATERIAL: fibre_cable_grip^ecdl | DWG NO. | A4 Aluminium
