spicydonkey/ecdl/B03/block_lid.PDF

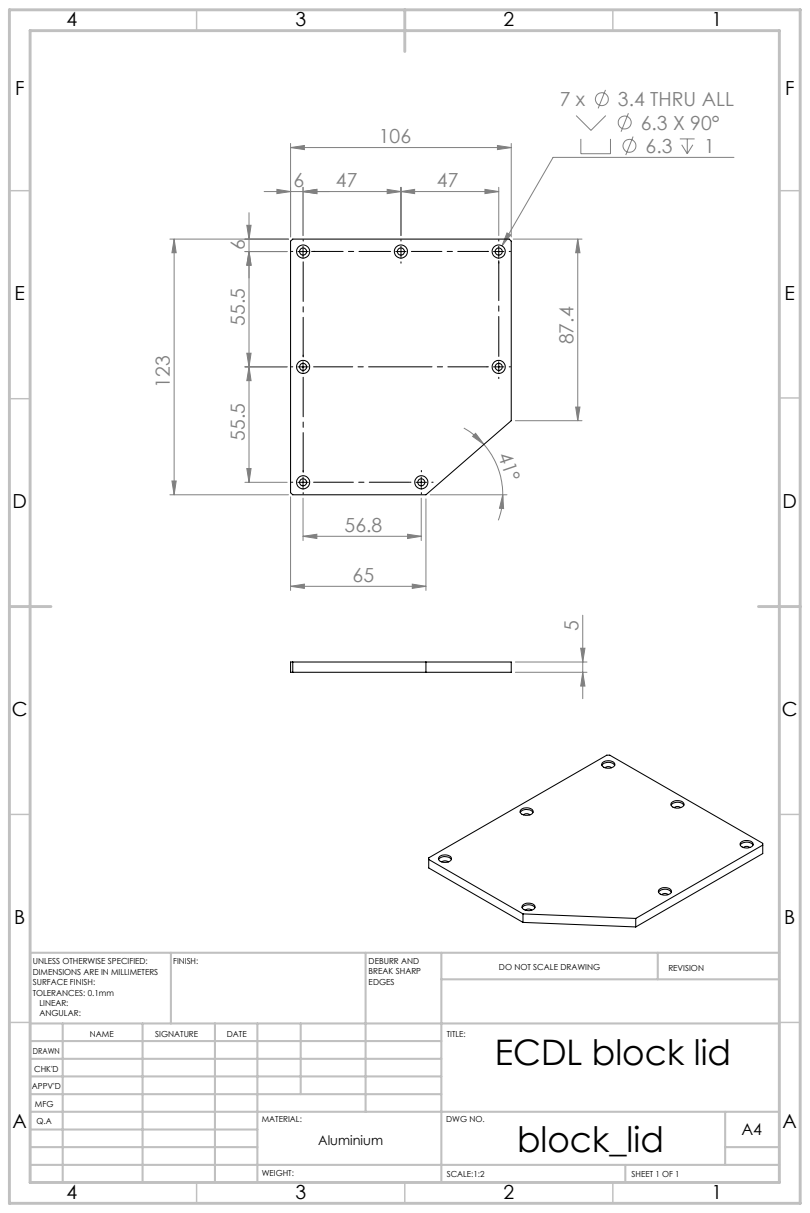
[picture p53: page 1]
3.4 THRU ALL; FINISH:; DEBURR AND; BREAK SHARP; DO NOT SCALE DRAWING; REVISION; SCALE:1:2; SHEET 1 OF 1

UNLESS OTHERWISE SPECIFIED:
DIMENSIONS ARE IN MILLIMETERS
SURFACE FINISH:
TOLERANCES: 0.1mm
LINEAR:
ANGULAR:

NAME | SIGNATURE | DATE | | | | TITLE: ECDL block lid

DRAWN
CHK'D
APPV'D
MFG
Q.A | | | | MATERIAL: | DWG NO. block_lid | A4 Aluminium
