spicydonkey/ecdl/B03/ecdl_block.PDF

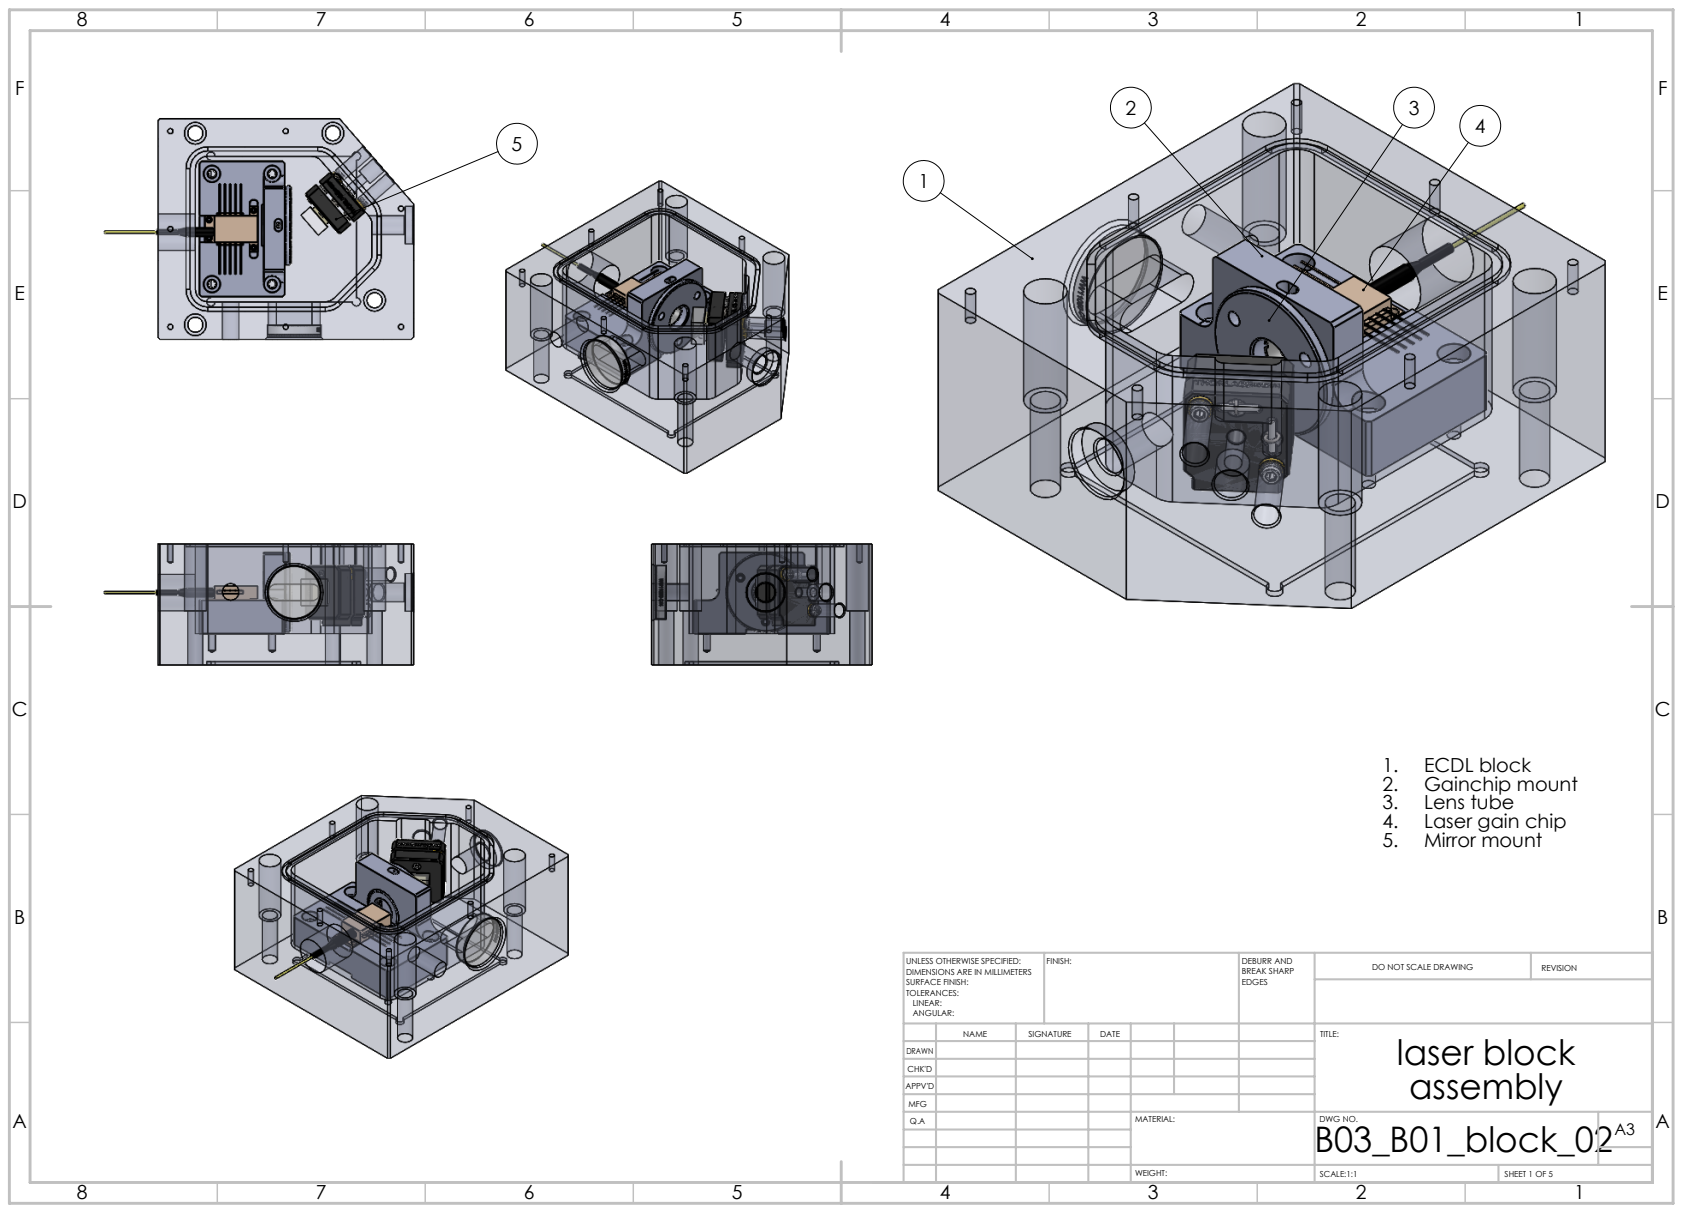
[picture p54: page 1]
FINISH:; DEBURR AND; BREAK SHARP; DO NOT SCALE DRAWING; REVISION

1. ECDL block
2. Gainchip mount
3. Lens tube
4. Laser gain chip
5. Mirror mount

UNLESS OTHERWISE SPECIFIED:
DIMENSIONS ARE IN MILLIMETERS
SURFACE FINISH:
TOLERANCES:
LINEAR:
ANGULAR:

NAME | SIGNATURE | DATE | | | | TITLE: laser block assembly

DRAWN
CHK'D
APPV'D
MFG
Q.A | | | | MATERIAL: | DWG NO. B03_B01_block_02 | A3

WEIGHT: | SCALE:1:1 | SHEET 1 OF 5

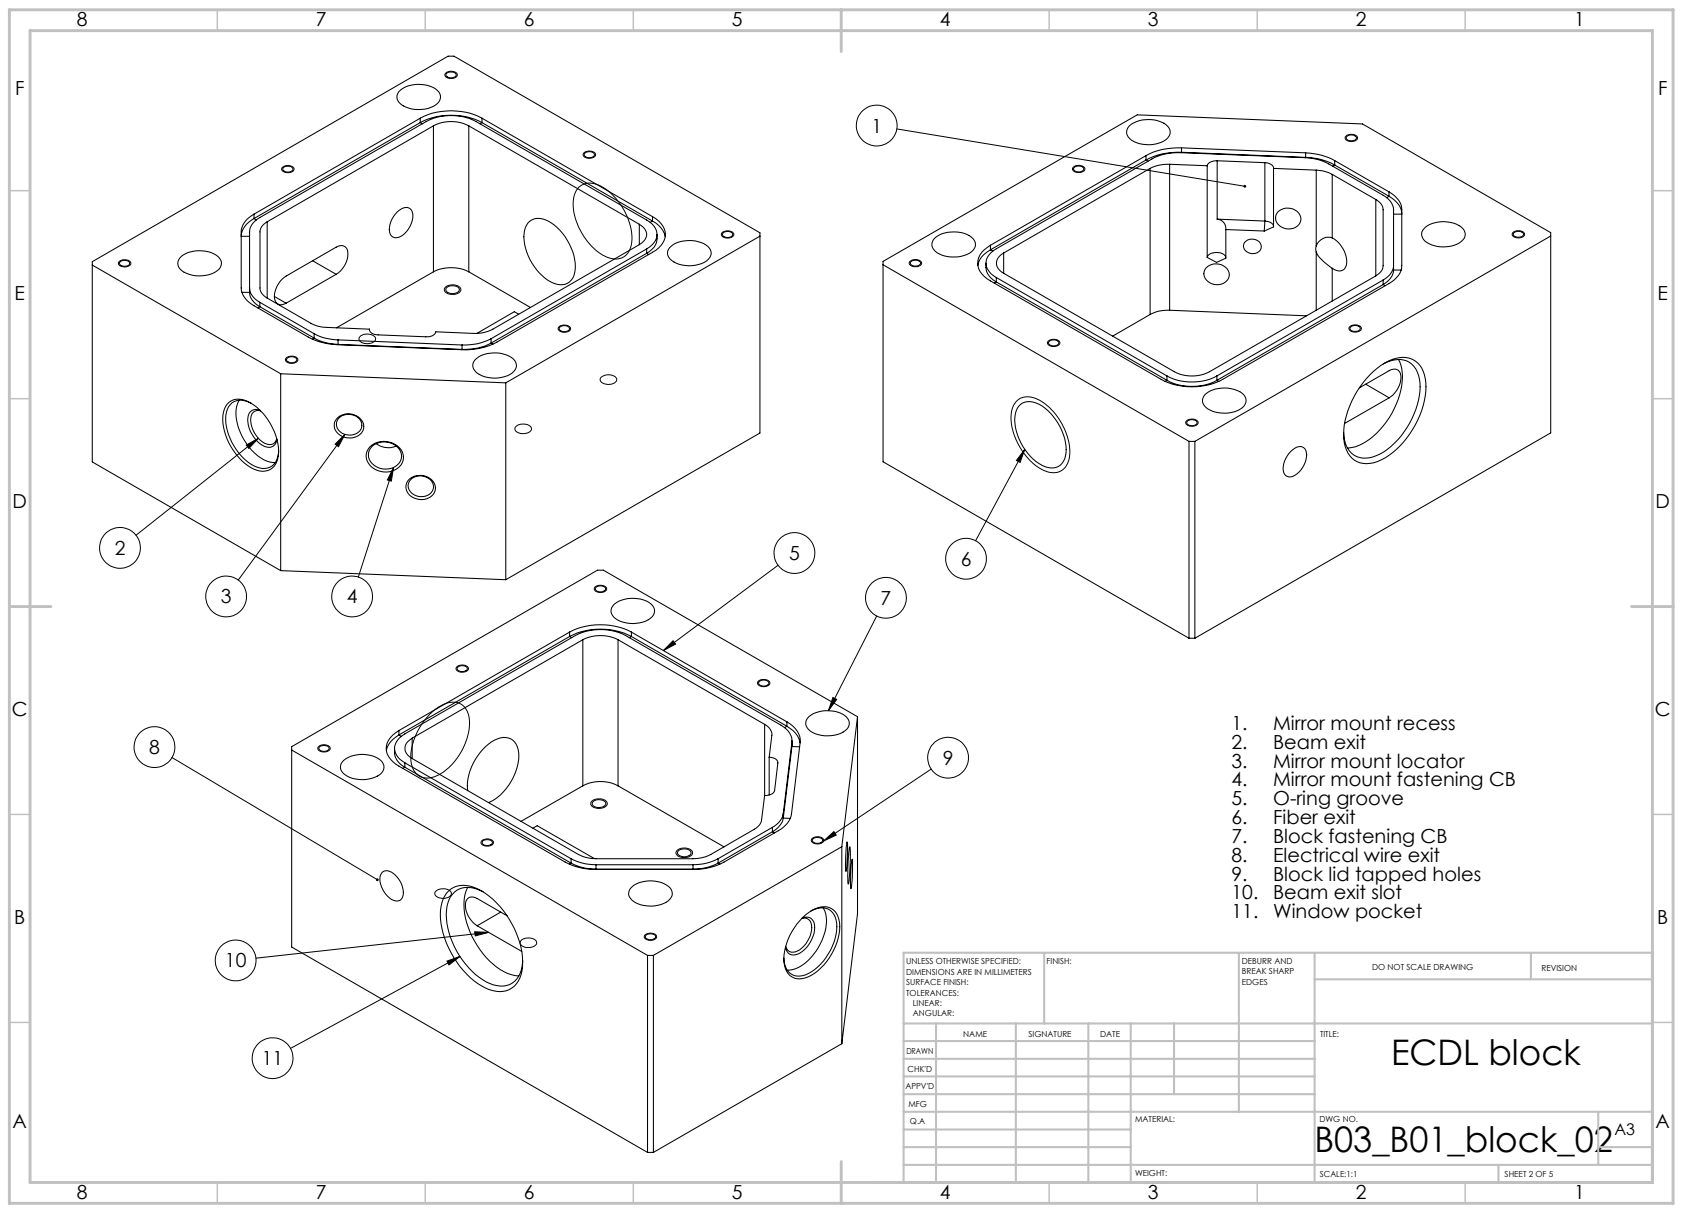
[picture p55: page 2]
FINISH:; DEBURR AND; BREAK SHARP; DO NOT SCALE DRAWING; REVISION

1. Mirror mount recess
2. Beam exit
3. Mirror mount locator
4. Mirror mount fastening CB
5. O-ring groove
6. Fiber exit
7. Block fastening CB
8. Electrical wire exit
9. Block lid tapped holes
10. Beam exit slot
11. Window pocket

UNLESS OTHERWISE SPECIFIED:
DIMENSIONS ARE IN MILLIMETERS
SURFACE FINISH:
TOLERANCES:
LINEAR:
ANGULAR:

NAME | SIGNATURE | DATE | TITLE: ECDL block

DRAWN
CHK'D
APPV'D
MFG

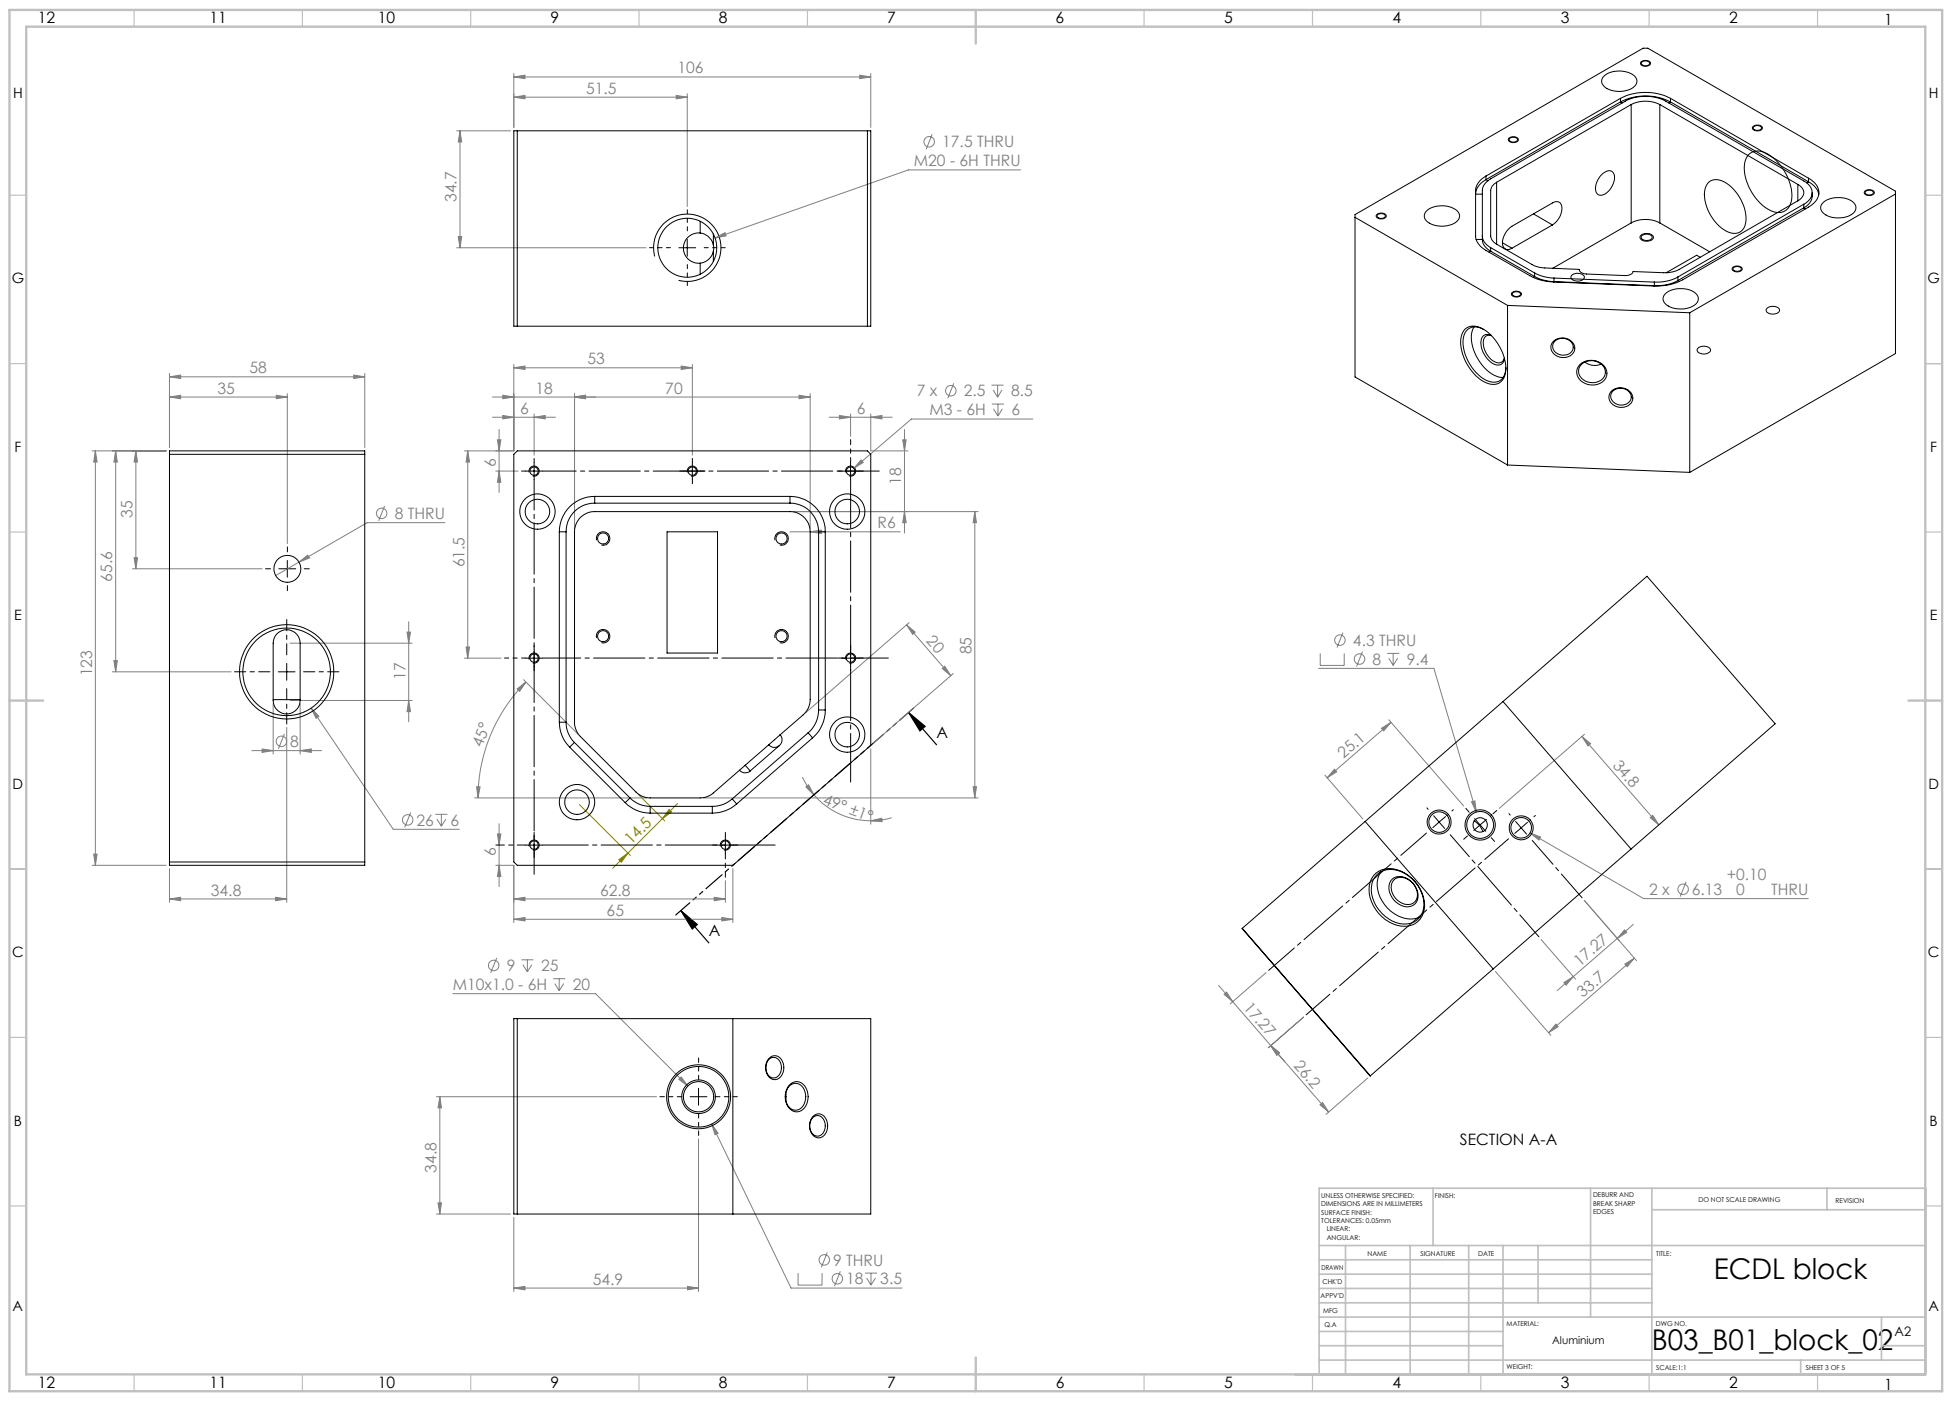
[picture p56: page 3]
8 THRU; 9 THRU 18 3.5; 17.5 THRU M20 - 6H THRU; 4.3 THRU 8 9.4; SECTION A-A; FINISH:; DEBURR AND; BREAK SHARP; DO NOT SCALE DRAWING; REVISION

UNLESS OTHERWISE SPECIFIED:
DIMENSIONS ARE IN MILLIMETERS
SURFACE FINISH:
TOLERANCES: 0.05mm
LINEAR:
ANGULAR:

NAME | SIGNATURE | DATE | | TITLE: ECDL block

DRAWN
CHK'D
APPV'D
MFG

A2 Aluminium

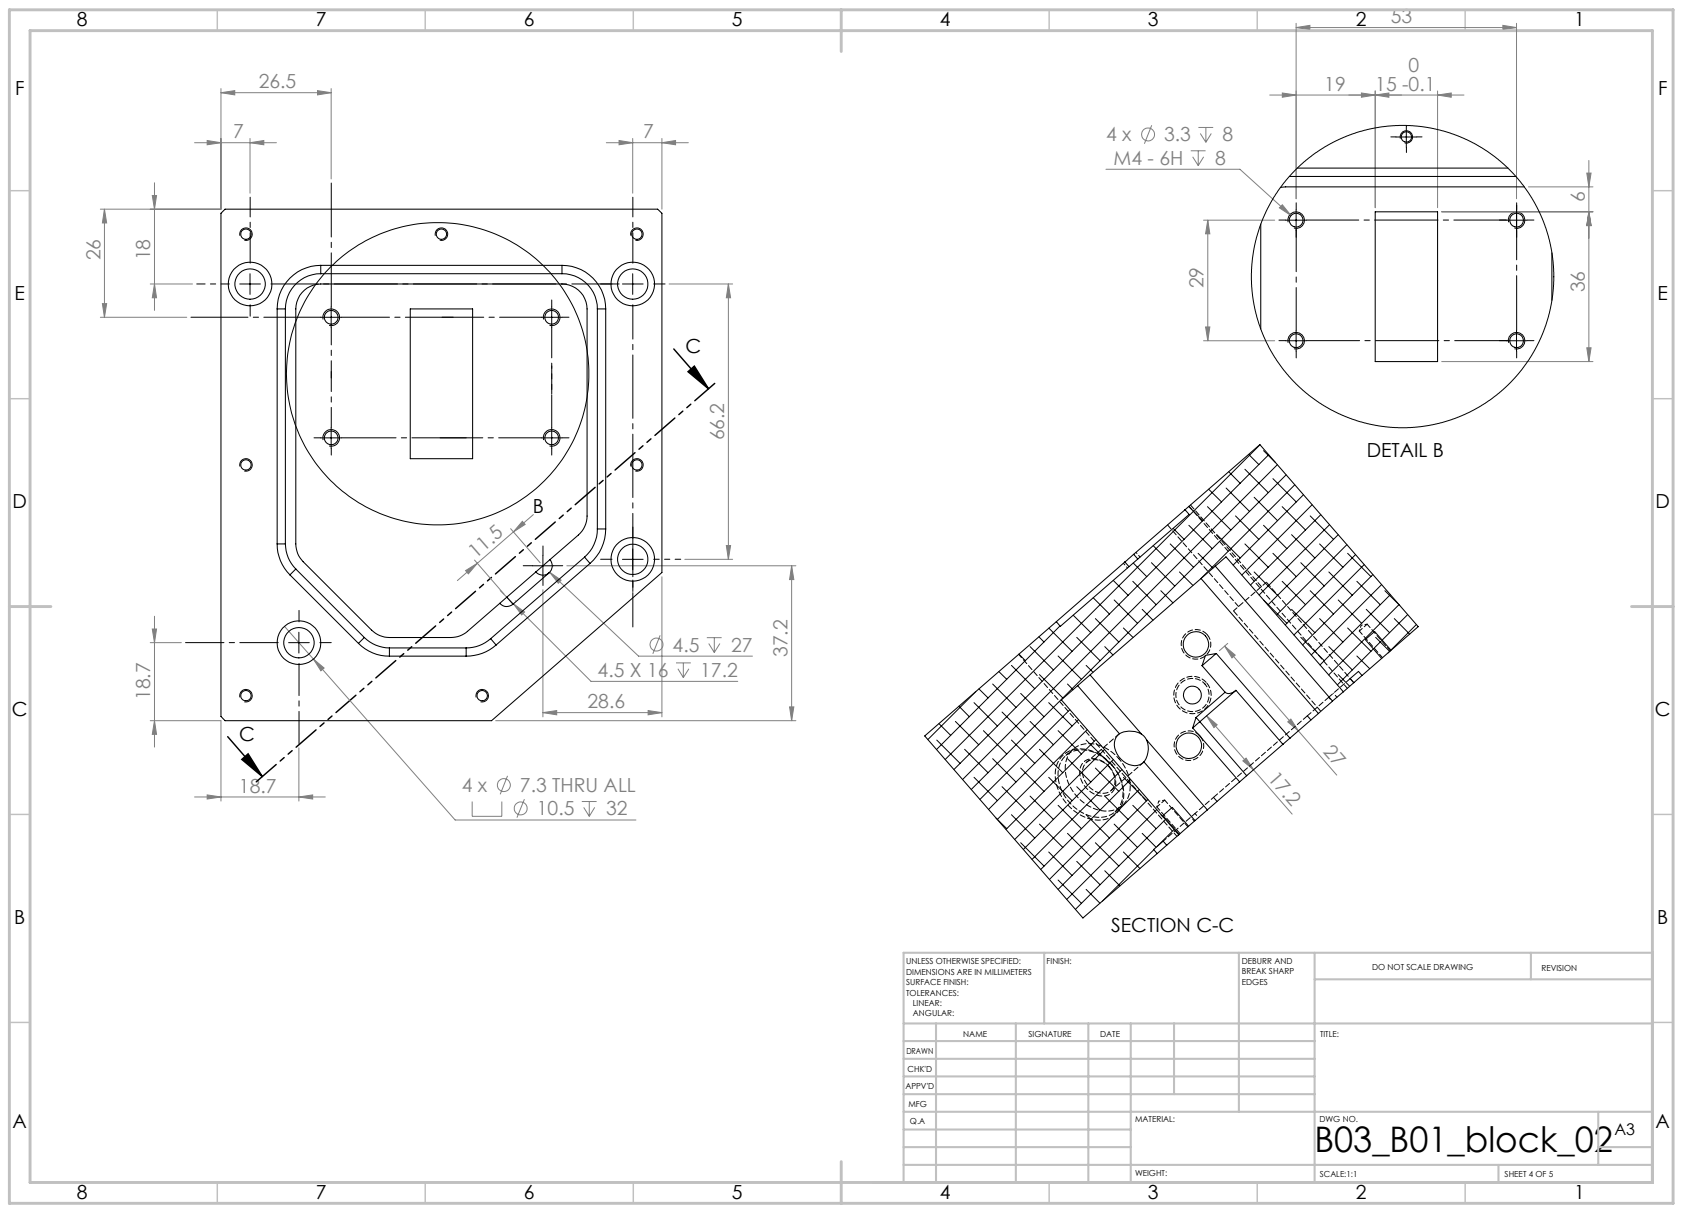
[picture p57: page 4]
7.3 THRU ALL; DETAIL B; SECTION C-C; FINISH:; DEBURR AND; BREAK SHARP; DO NOT SCALE DRAWING; REVISION

UNLESS OTHERWISE SPECIFIED:
DIMENSIONS ARE IN MILLIMETERS
SURFACE FINISH:
TOLERANCES:
LINEAR:
ANGULAR:

NAME | SIGNATURE | DATE | TITLE:

DRAWN
CHK'D
APPV'D
MFG

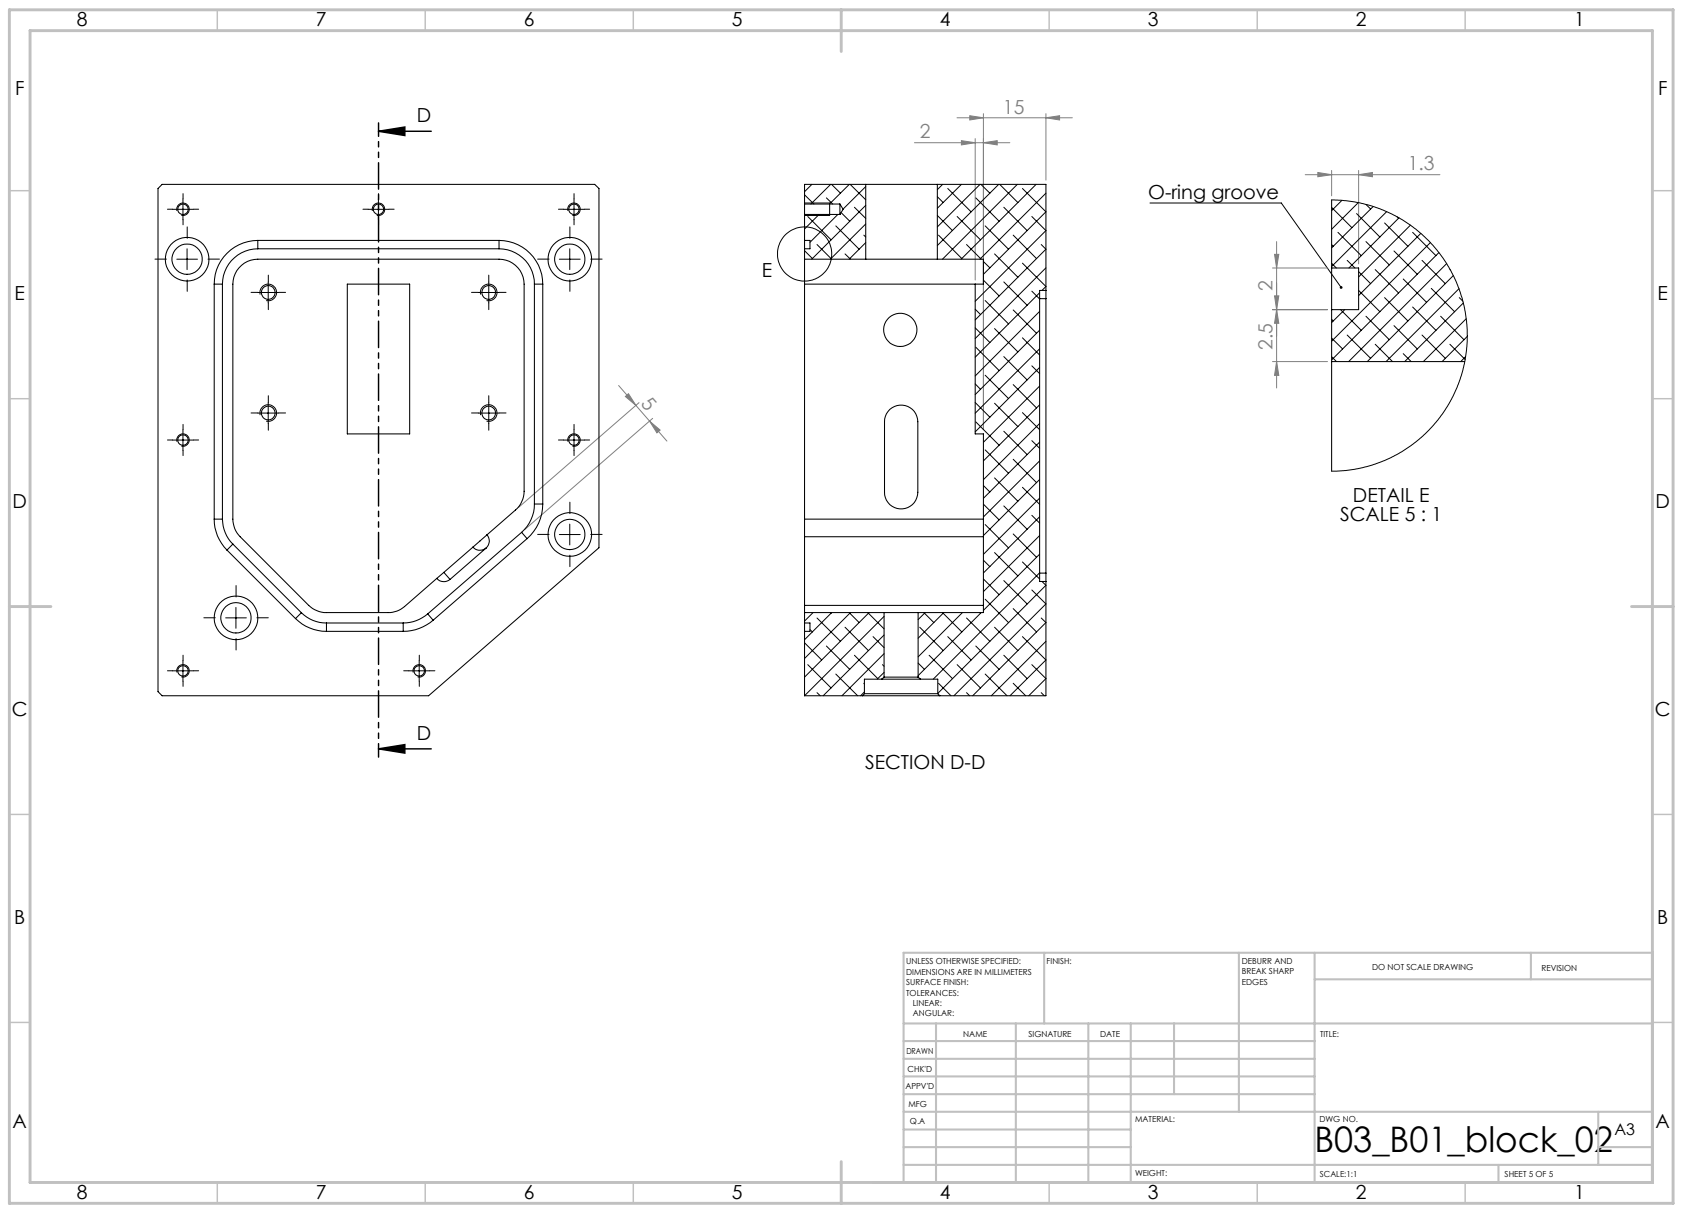
[picture p58: page 5]
SECTION D-D; DETAIL E SCALE 5 : 1; O-ring groove; FINISH:; DEBURR AND; BREAK SHARP; DO NOT SCALE DRAWING; REVISION

UNLESS OTHERWISE SPECIFIED:
DIMENSIONS ARE IN MILLIMETERS
SURFACE FINISH:
TOLERANCES:
LINEAR:
ANGULAR:

NAME | SIGNATURE | DATE | TITLE:

DRAWN
CHK'D
APPV'D
MFG
