spicydonkey/ecdl/B03/gainchip_mount.PDF

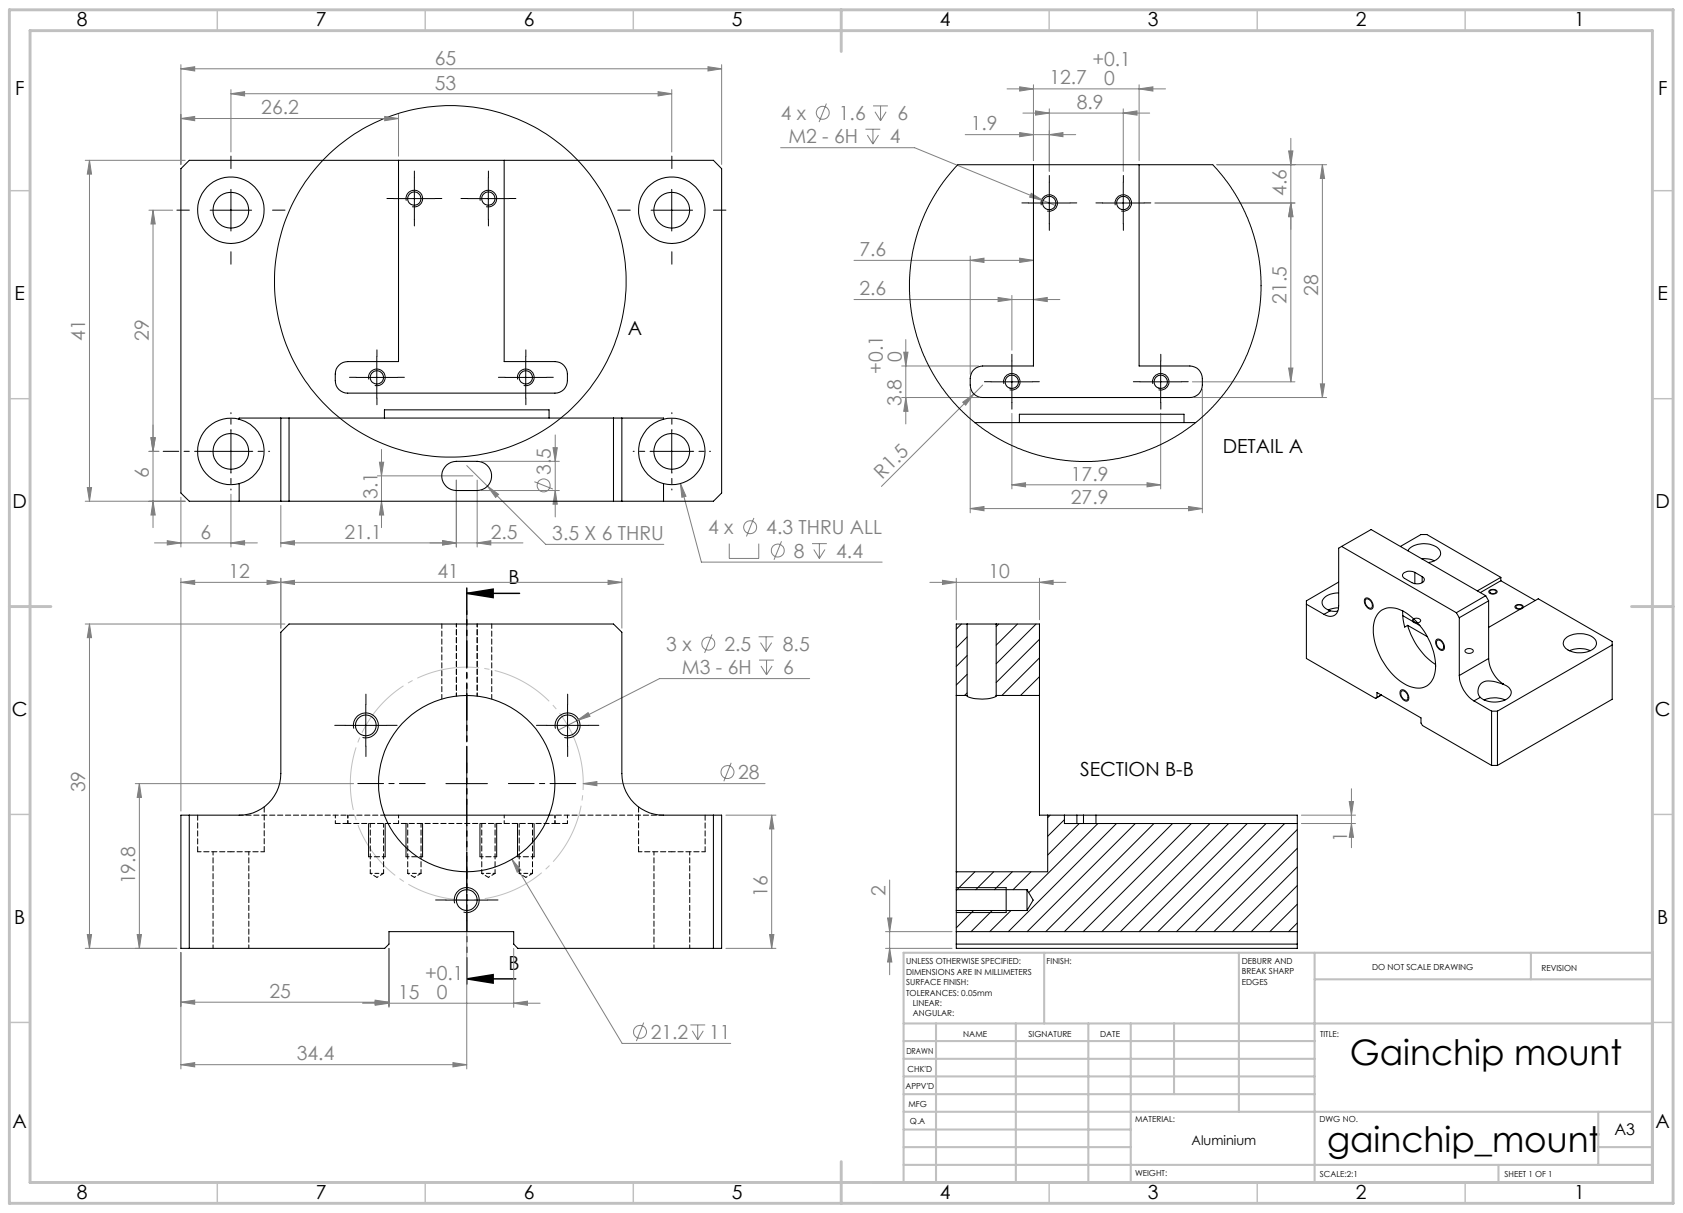
[picture p59: page 1]
4.3 THRU ALL; 3.5 X 6 THRU; DETAIL A; SECTION B-B; FINISH:; DEBURR AND; BREAK SHARP; DO NOT SCALE DRAWING; REVISION; SCALE:2:1; SHEET 1 OF 1

UNLESS OTHERWISE SPECIFIED:
DIMENSIONS ARE IN MILLIMETERS
SURFACE FINISH:
TOLERANCES: 0.05mm
LINEAR:
ANGULAR:

NAME | SIGNATURE | DATE | | | | TITLE: Gainchip mount

DRAWN
CHK'D
APPV'D
MFG
Q.A | | | | MATERIAL: | DWG NO. gainchip_mount | A3 Aluminium
