spicydonkey/ecdl/B03/lens_tube.PDF

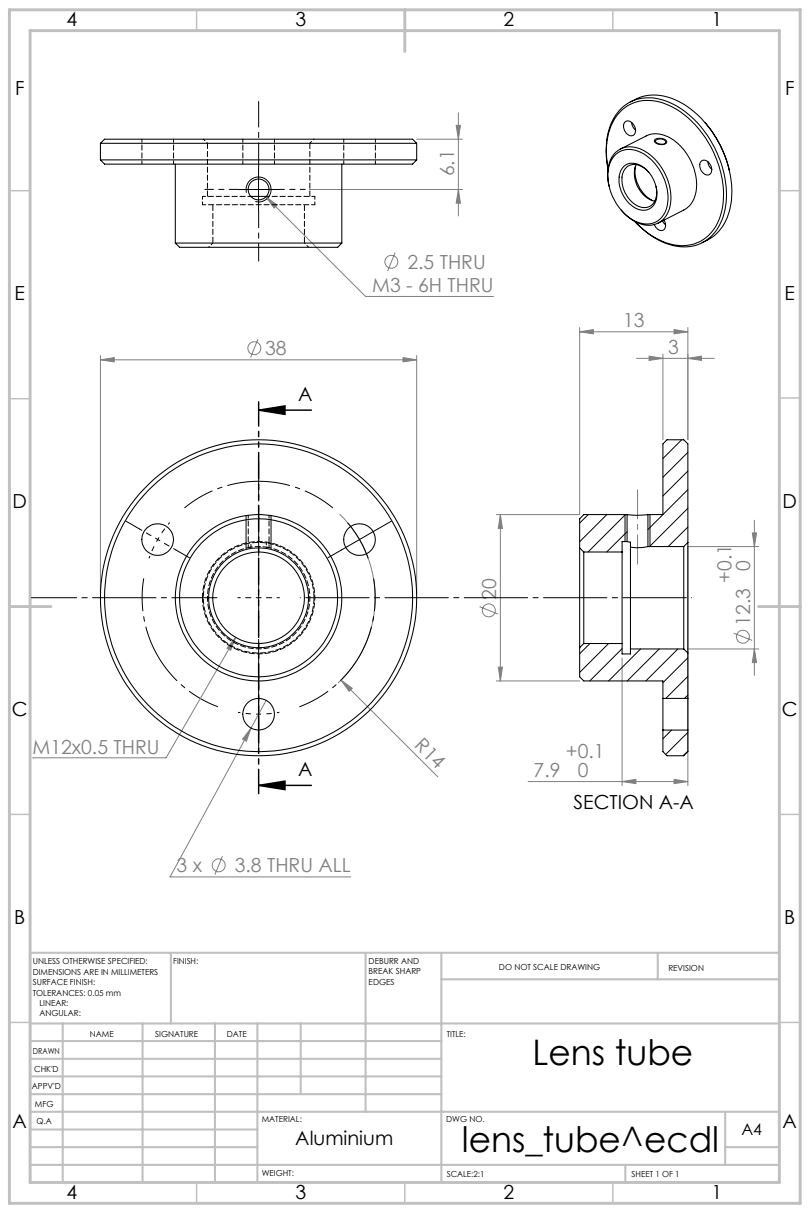
[picture p60: page 1]
M12x0.5 THRU; 3.8 THRU ALL; SECTION A-A; 2.5 THRU M3 - 6H THRU; FINISH:; DEBURR AND; BREAK SHARP; DO NOT SCALE DRAWING; REVISION; SCALE:2:1; SHEET 1 OF 1

UNLESS OTHERWISE SPECIFIED:
DIMENSIONS ARE IN MILLIMETERS
SURFACE FINISH:
TOLERANCES: 0.05 mm
LINEAR:
ANGULAR:

NAME | SIGNATURE | DATE | | | | TITLE: Lens tube

DRAWN
CHK'D
APPV'D
MFG
Q.A | | | | MATERIAL: Aluminium | DWG NO. lens_tube^ecdl | A4
