spicydonkey/ecdl/Thorlabs/743201004-other-technical-4-en.pdf

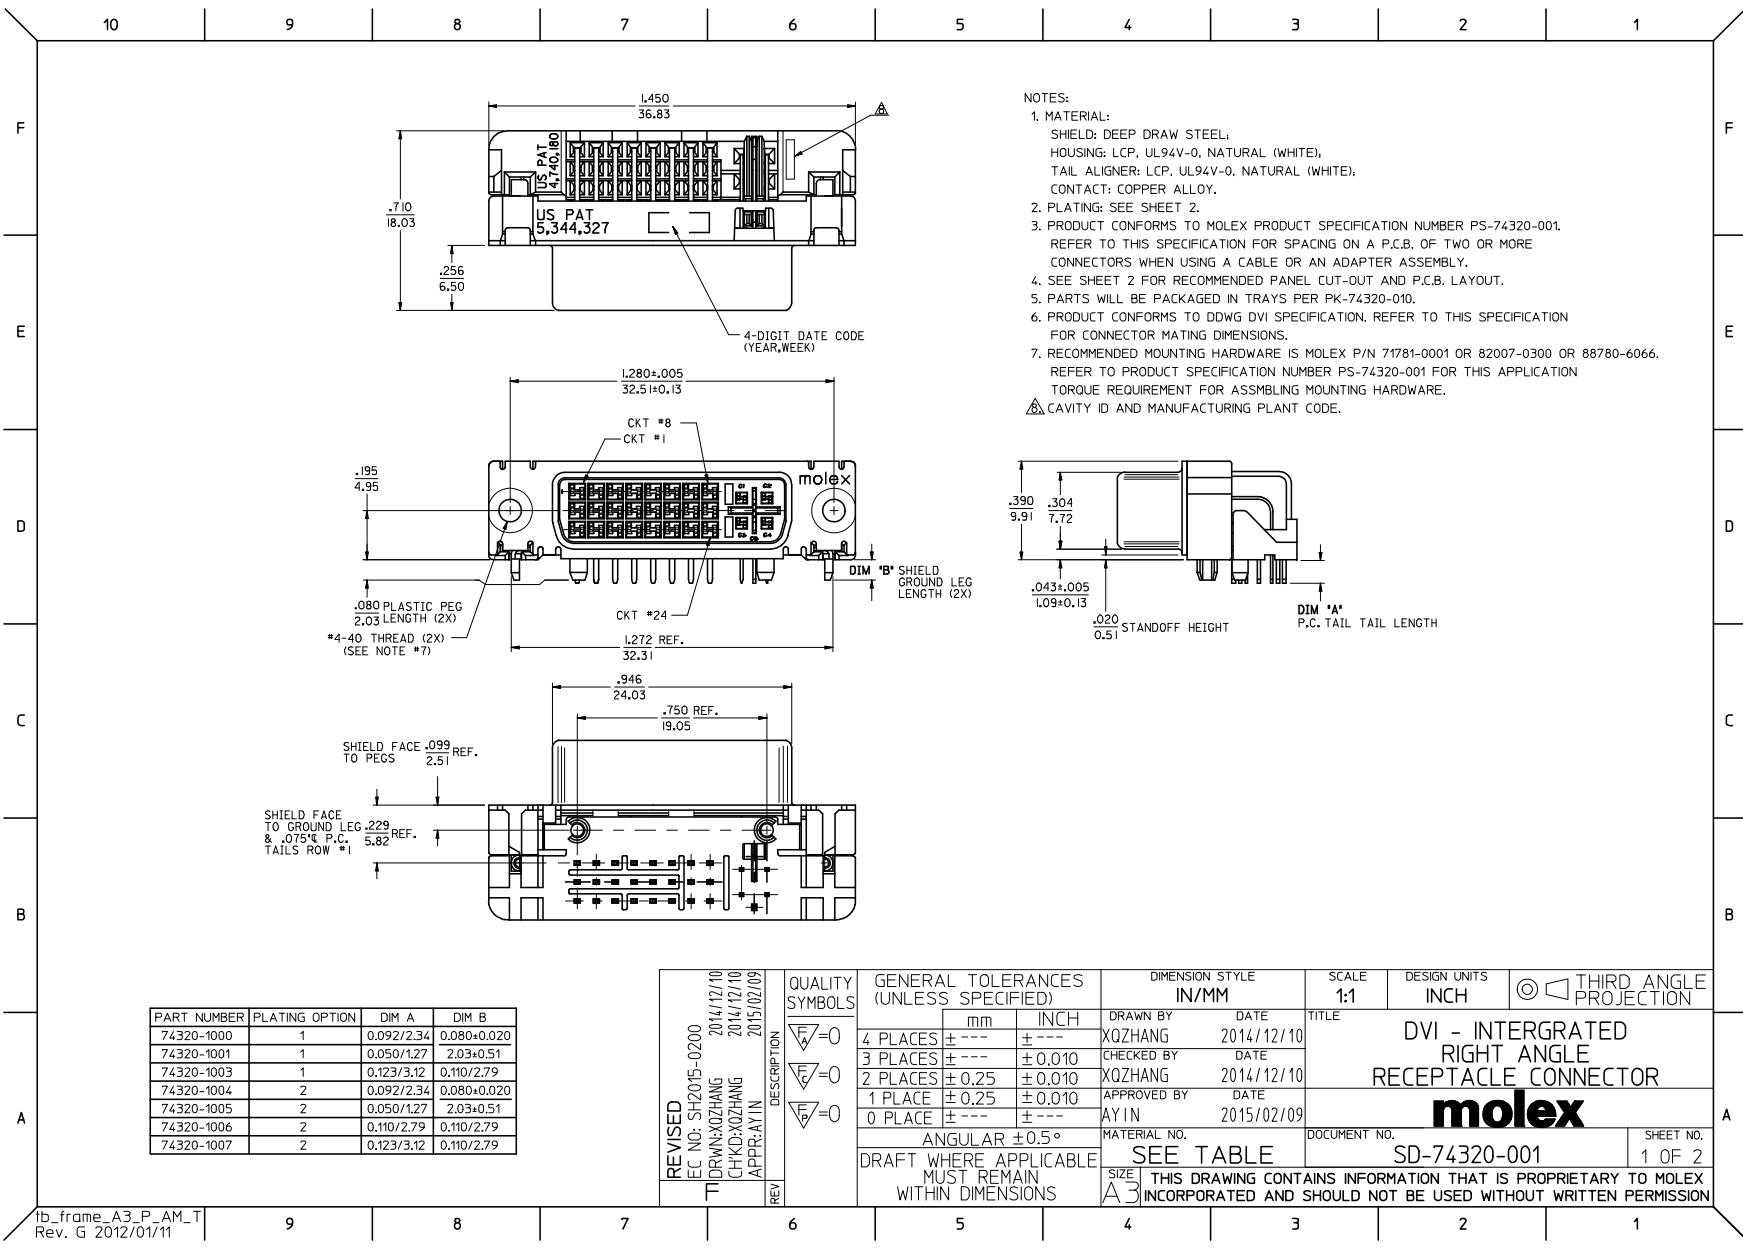
[picture p61: page 1]

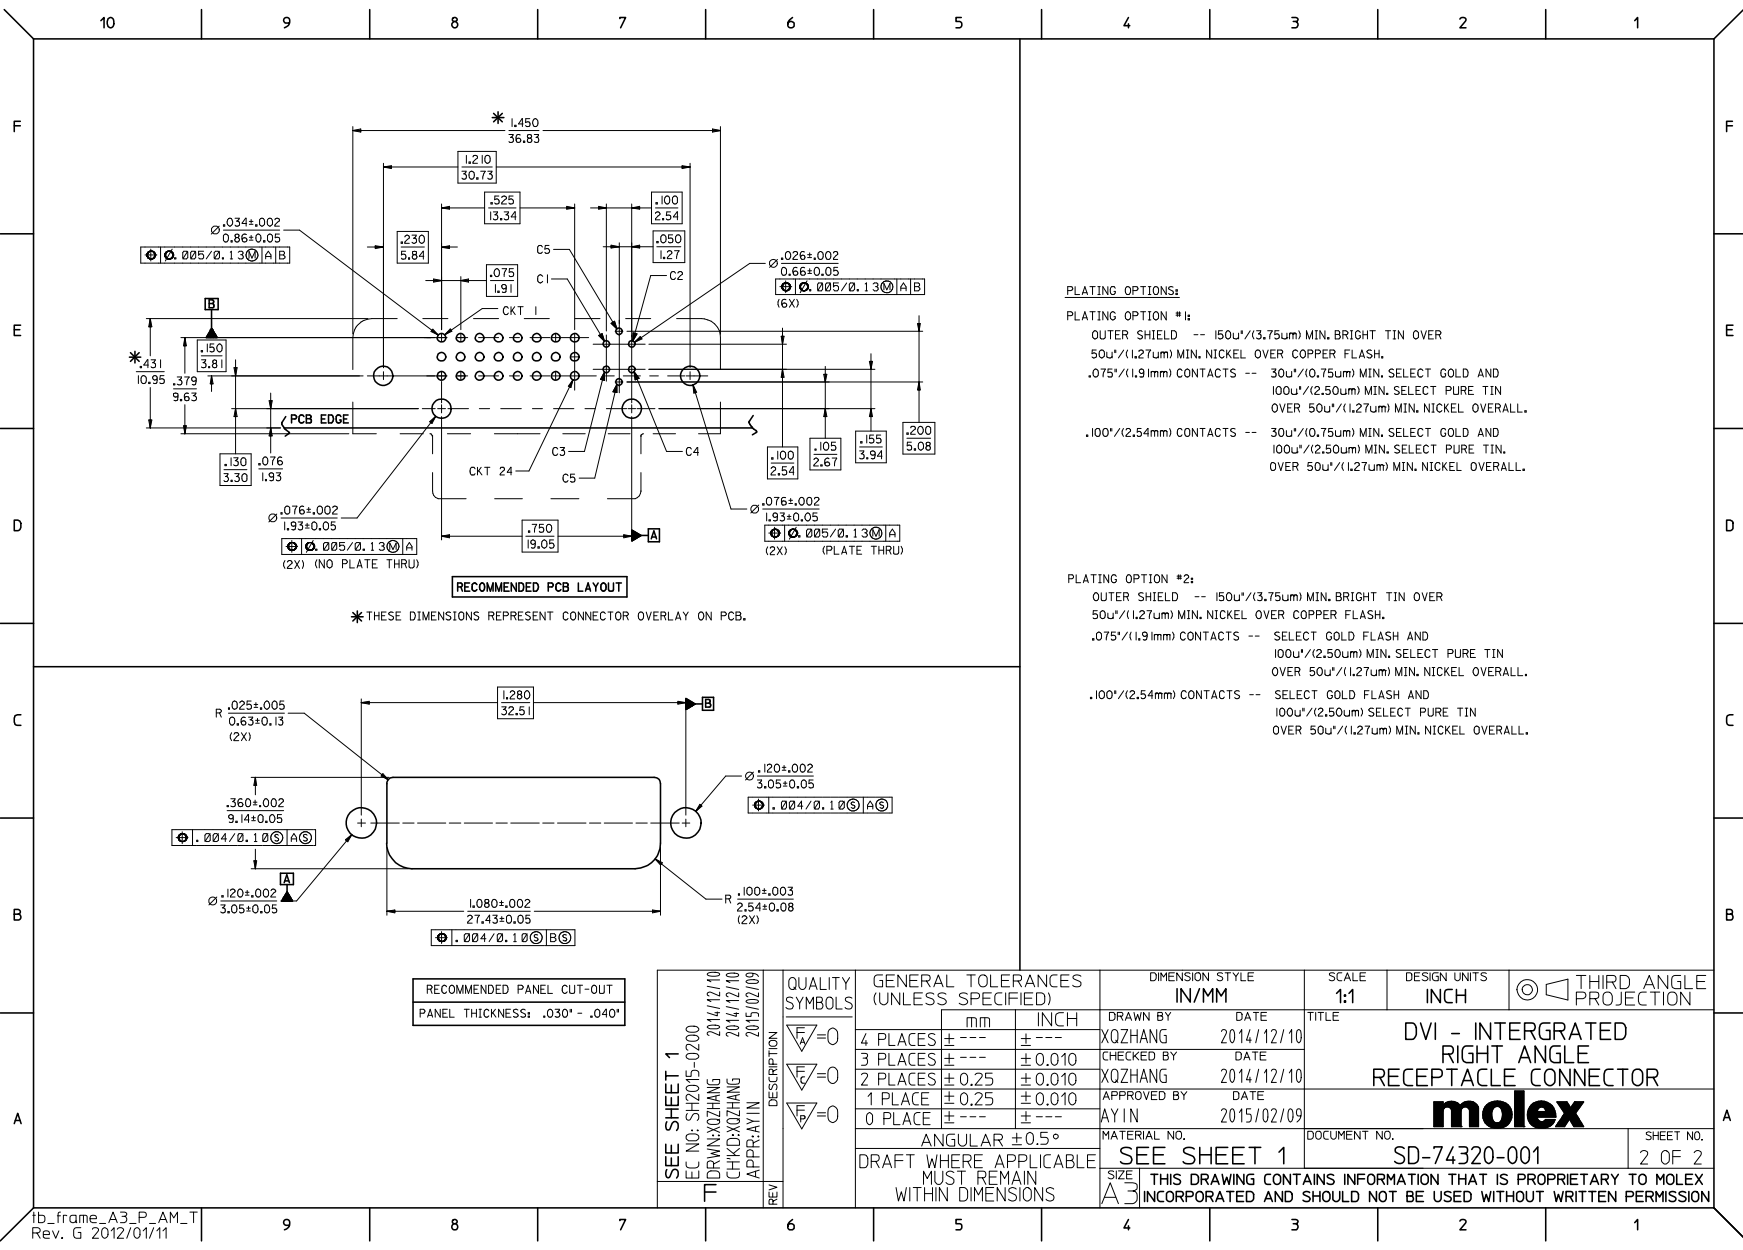
[picture p62: page 2]

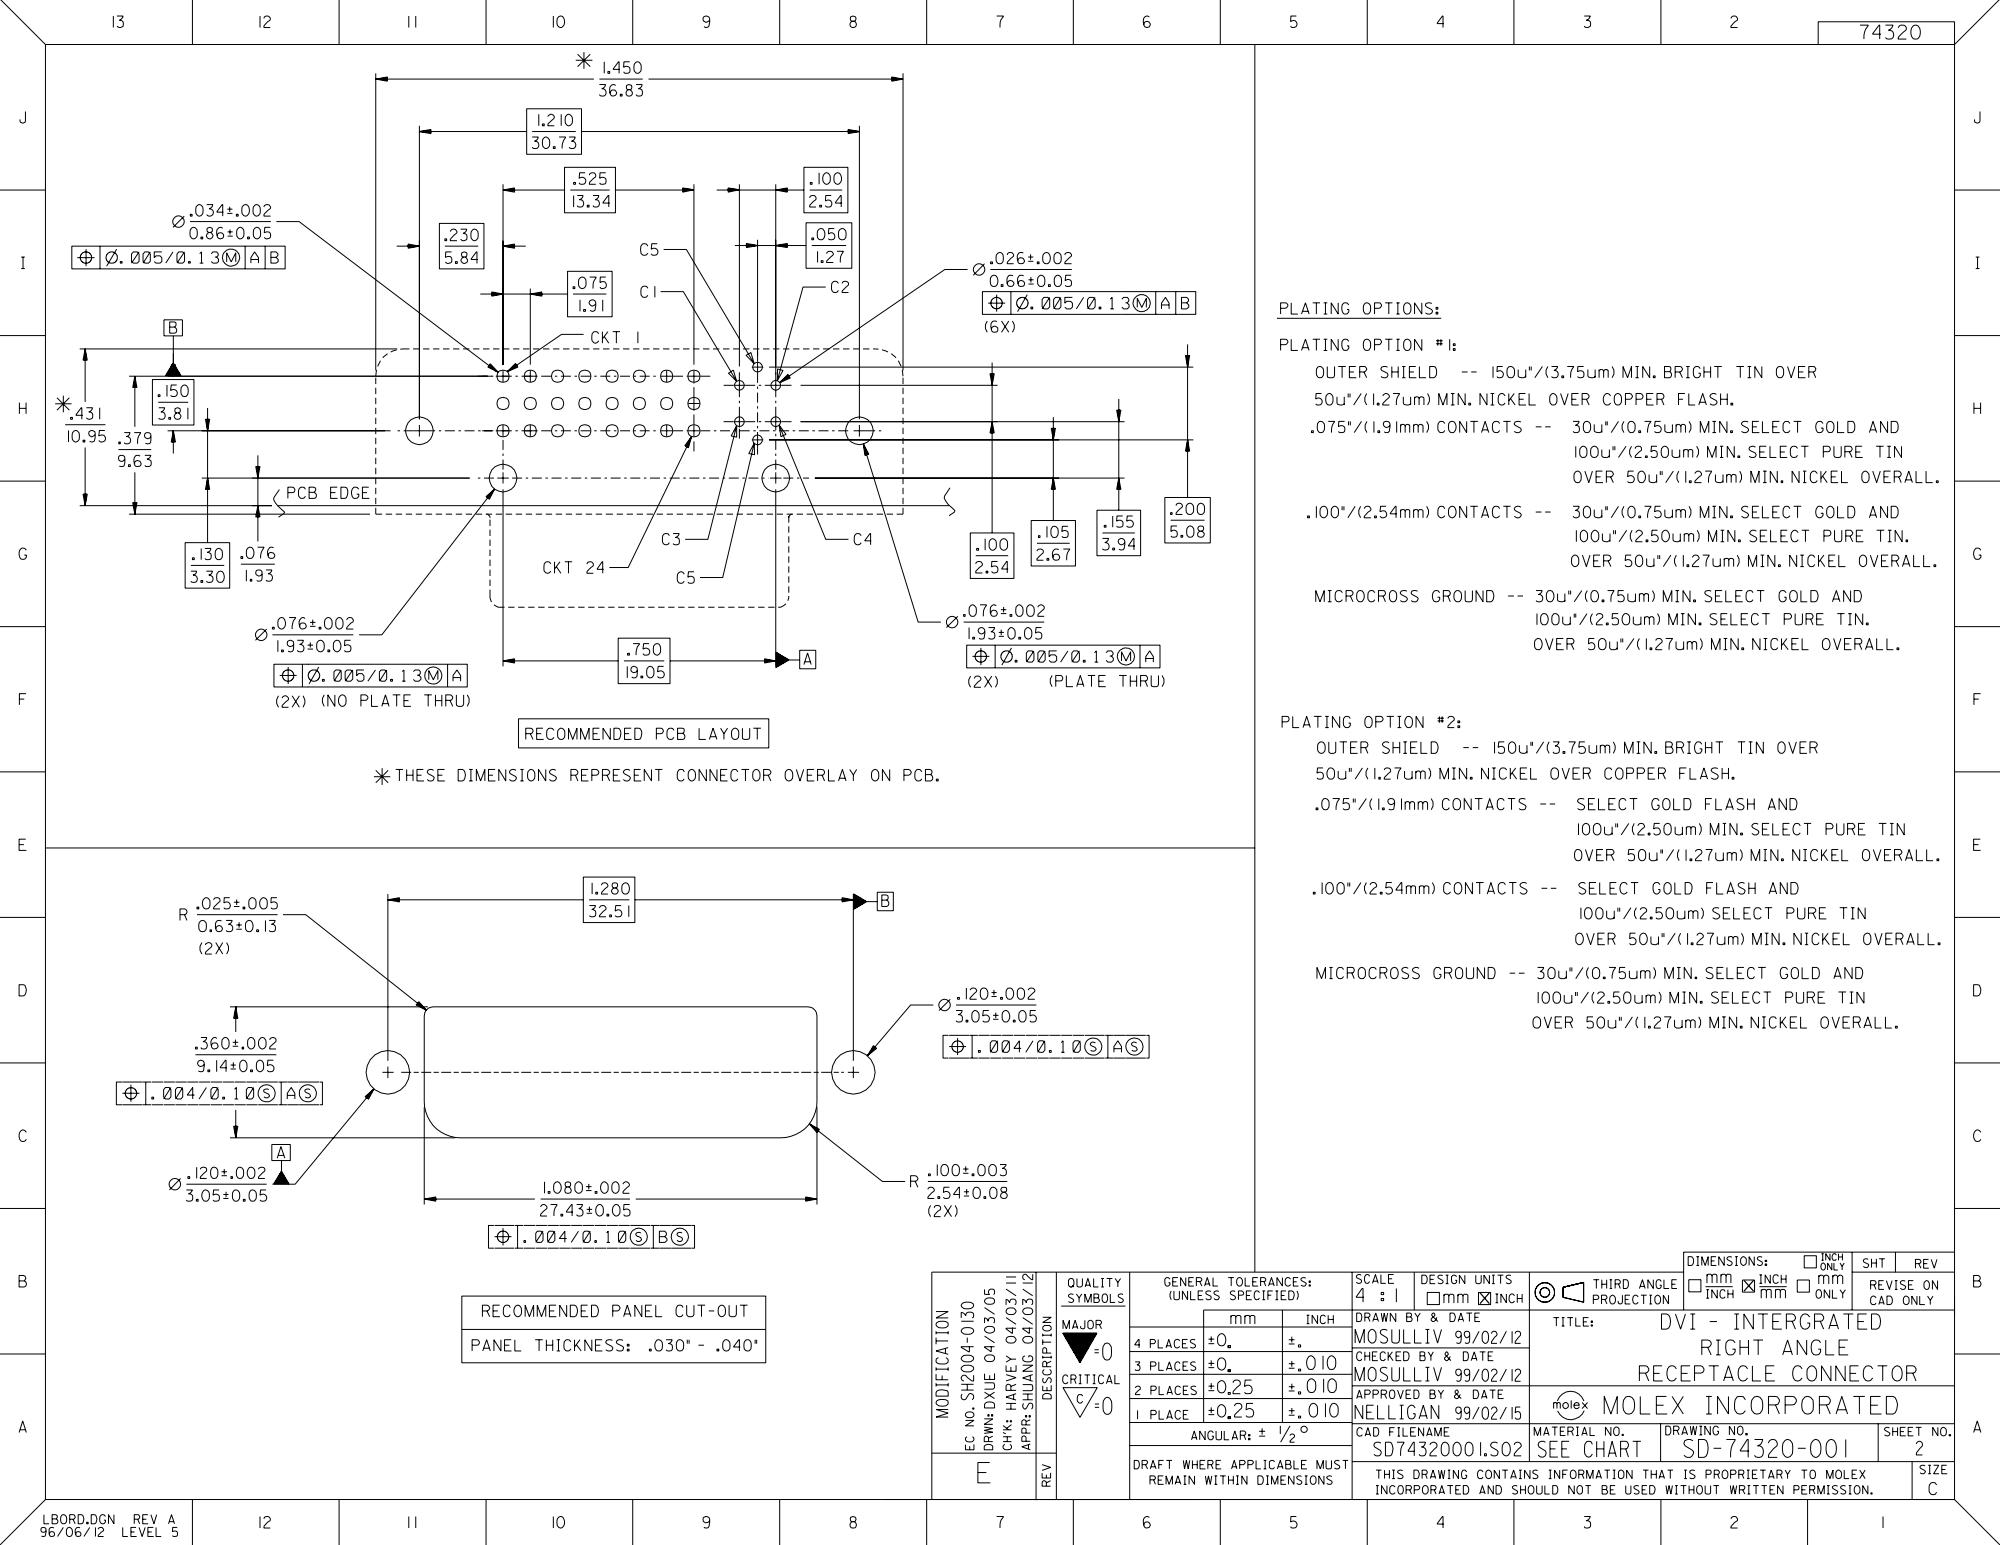
[picture p63: page 3]
