spicydonkey/ecdl/Thorlabs/743205004-other-technical-4-en.pdf

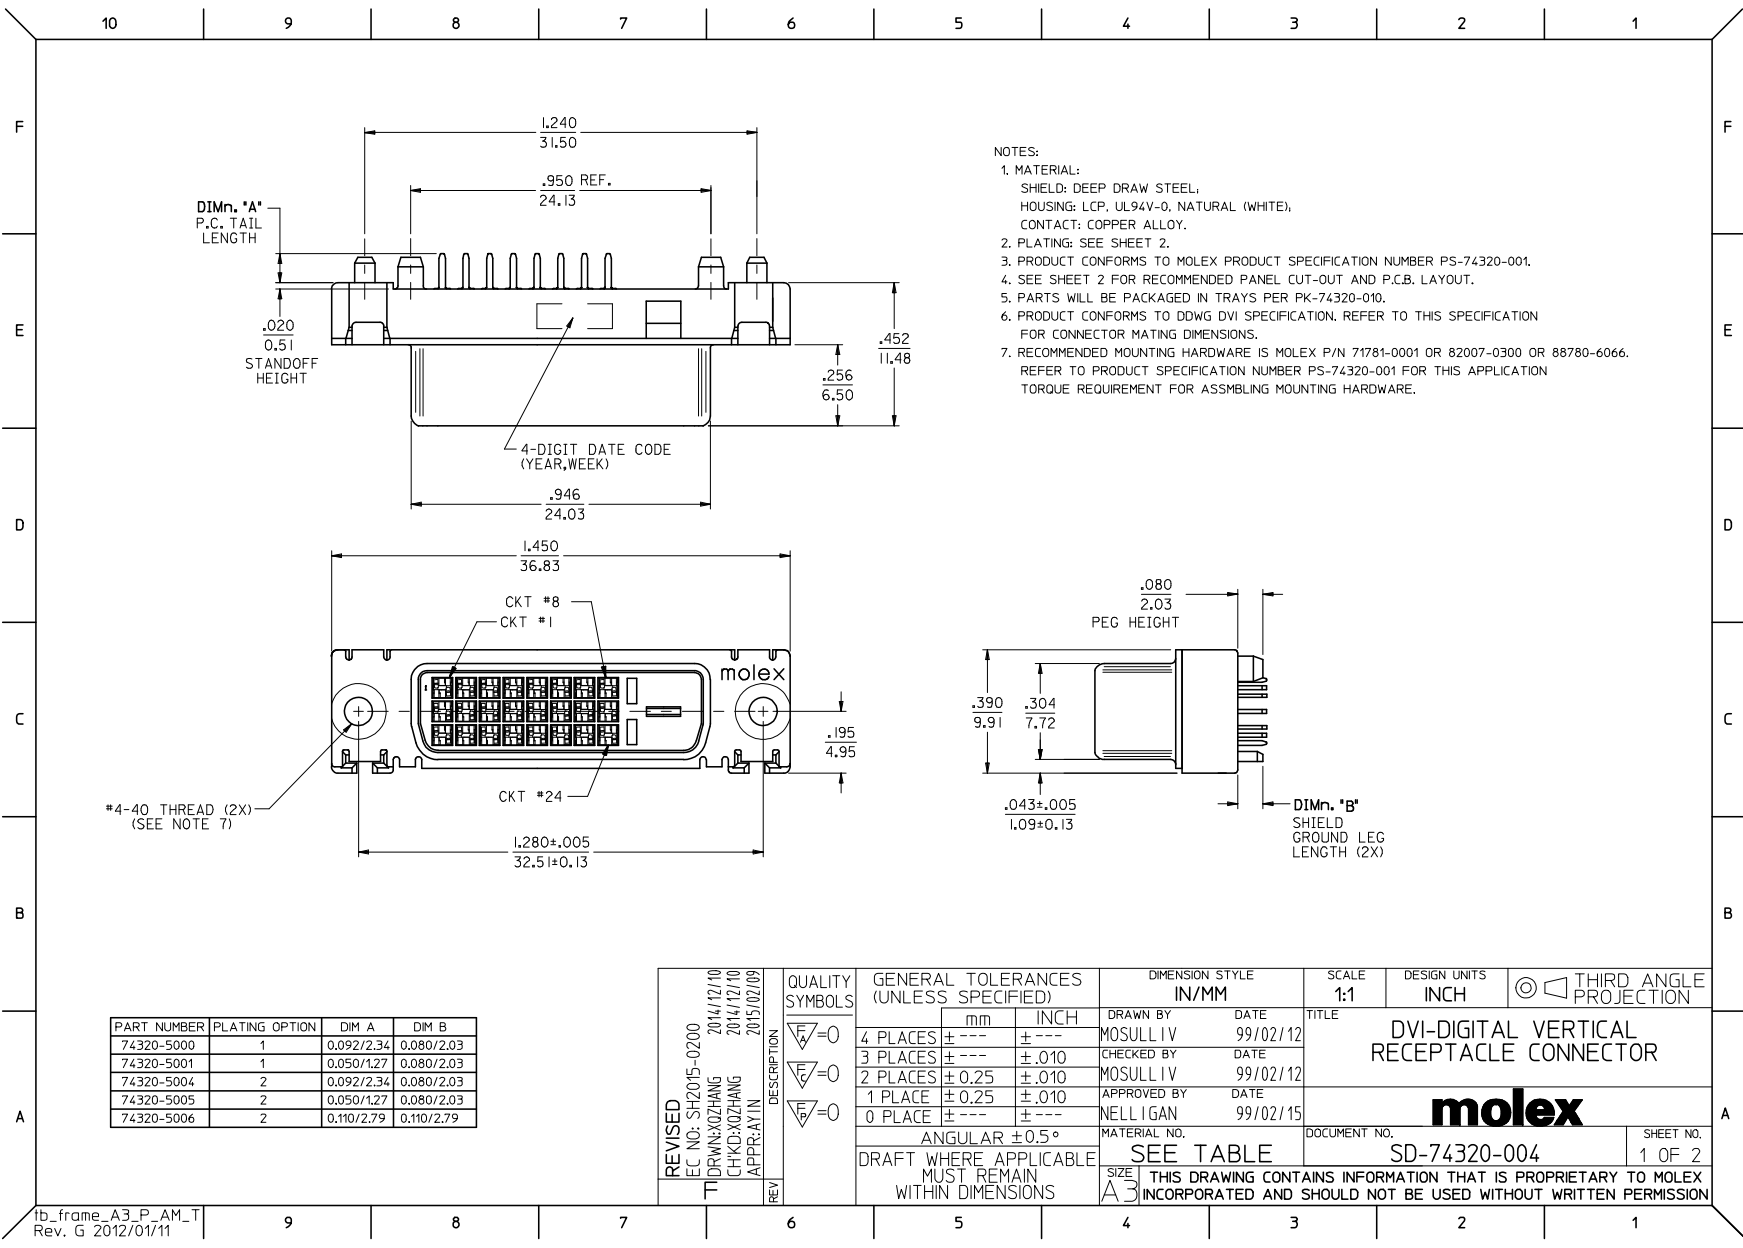
[picture p64: page 1]

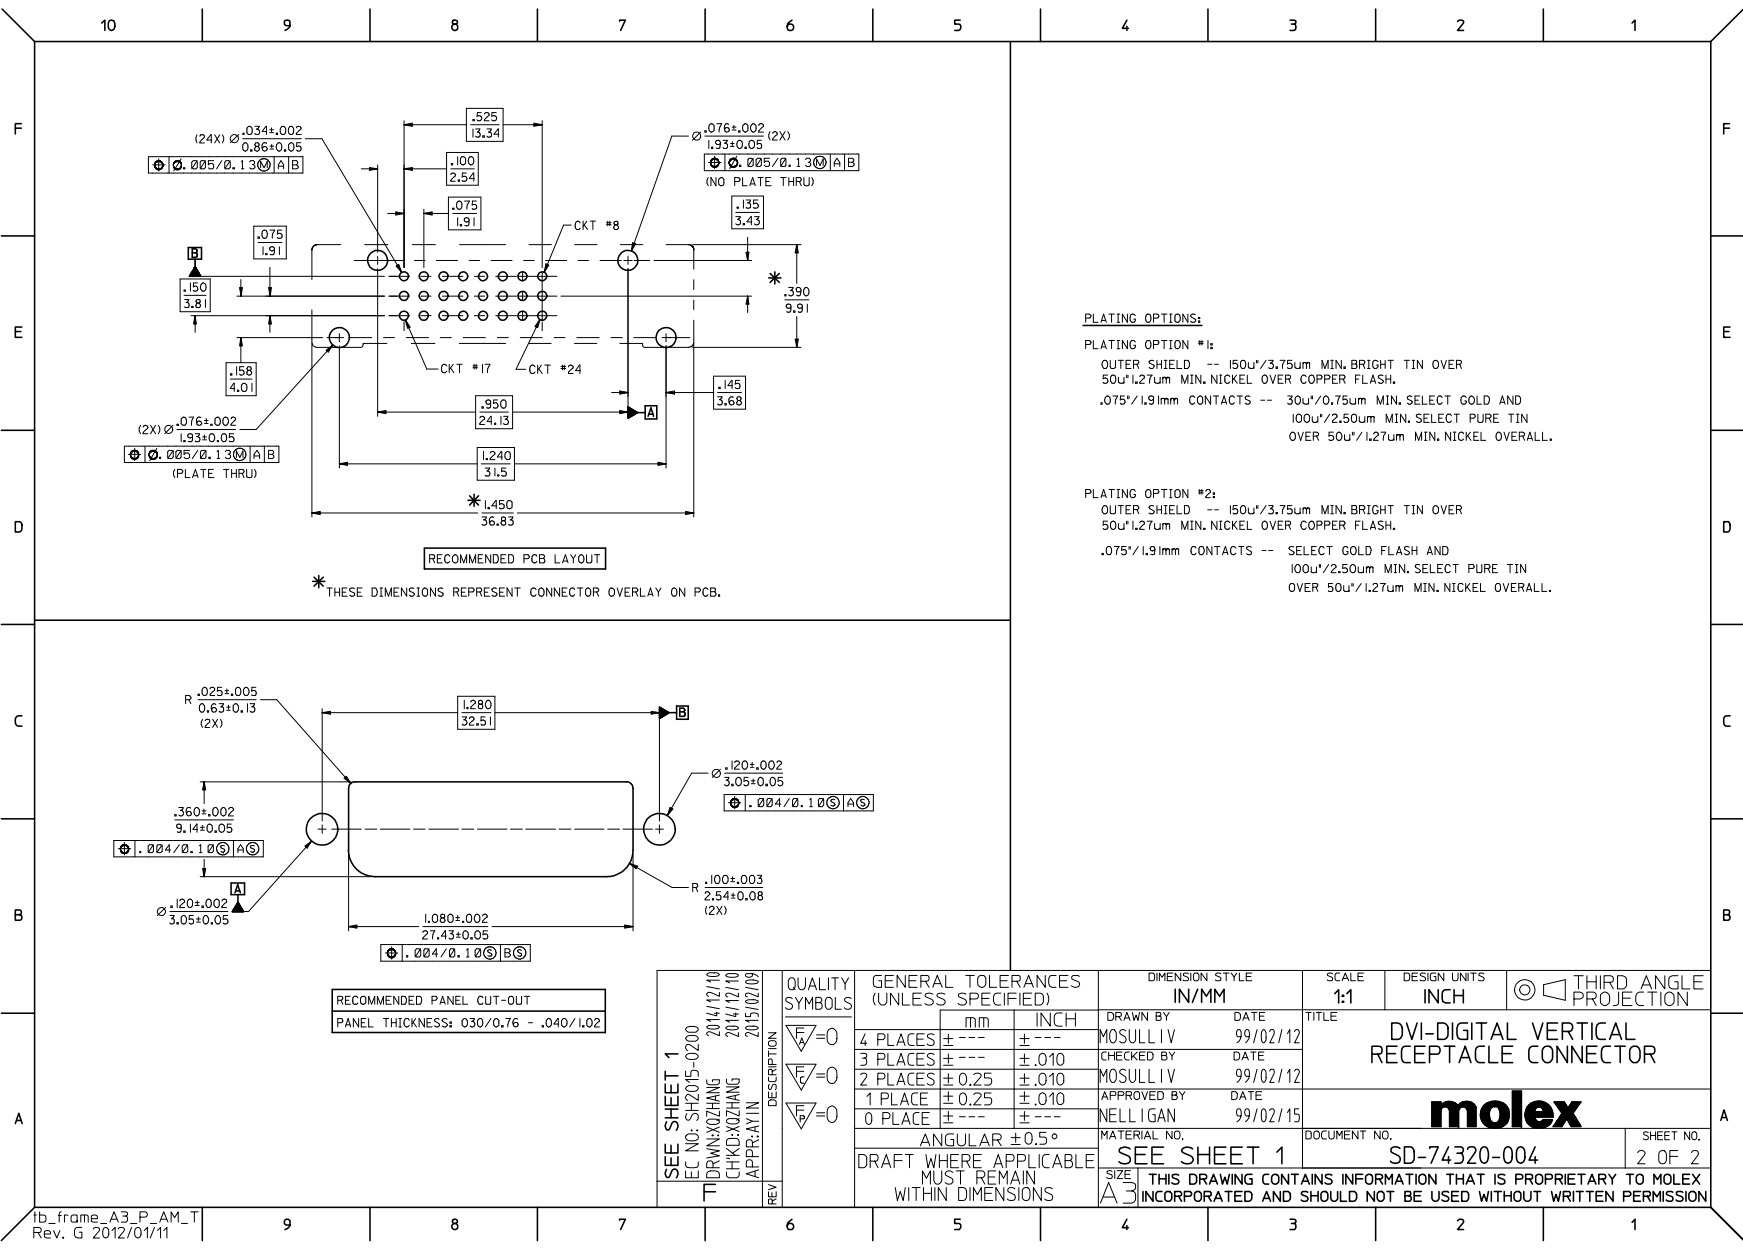
[picture p65: page 2]
