spicydonkey/ecdl/(commit log)

2015-09-11 Conceptual design Bryce's design
    [AD1109F-Solidworks.sldprt, B01_block.SLDPRT, B01_gainchip.SLDASM, B01_gainchip_mount.SLDPRT, B01_lens.SLDASM, B01_mock.SLDASM, B01_slip_mount.SLDPRT, B01_slip_plate.SLDPRT]
2015-09-14 Make block lid (ref to mates in asm)
    [B01_block.SLDPRT, B01_block_1.SLDPRT, B01_block_lid.SLDPRT, B01_block_lid_1.SLDPRT, B01_ecdl_1.SLDASM, B01_gainchip.SLDASM, B01_gainchip_1.SLDASM, B01_gainchip_mount_1.SLDPRT]
2015-09-14 Create grating subasm and include in B01
    [B01_block.SLDPRT, B01_block_lid.SLDPRT, B01_mock.SLDASM, GR13-1210-Solidworks.sldprt, PA4FK-Solidworks.sldprt, PA4FKW-Solidworks.sldprt, grating_sub.SLDASM]
2015-09-15 Add wedge window grating not aligned to the beam and window needs to centre beam
    [B01_block.SLDPRT, B01_mock.SLDASM, WW11050-C13-Solidworks.sldprt]
2015-09-15 Fix O-ring slot, round mount and slots: shorten cavity
    [B01_block.SLDPRT, B01_block_lid.SLDPRT, B01_lens.SLDASM, B01_mock.SLDASM, B01_slip_mount.SLDPRT, B01_slip_plate.SLDPRT]
2015-09-15 Fix error in lid referencing to block dimension
    [B01_block.SLDPRT, B01_block_lid.SLDPRT, B01_gainchip.SLDASM, B01_lens.SLDASM, B01_mock.SLDASM, grating_sub.SLDASM]
2015-09-15 Clean up design tree
    [B01_mock.SLDASM]
2015-09-16 Redesign slip-plate configuration and revise unstable refs and mates
    [B01_block.SLDPRT, B01_lens.SLDASM, B01_mock.SLDASM, B01_slip_mount.SLDPRT, B01_slip_plate.SLDPRT]
2015-09-16 Revise refs with KMSS grating subasm and centre grating to laser spot
    [B01_block.SLDPRT, B01_block_lid.SLDPRT, B01_lens.SLDASM, B01_mock.SLDASM, B01_slip_mount.SLDPRT, B01_slip_plate.SLDPRT]
2015-09-16 Add slots in block for protruding pins from the mirror mount
    [B01_block.SLDPRT, B01_mock.SLDASM, grating_sub.SLDASM]
2015-09-16 Start re-modelling the components for ease of design parameter change
    [B01_block.SLDPRT, B01_block_lid.SLDPRT, B01_gainchip.SLDASM, B01_gainchip_mount.SLDPRT, B01_lens.SLDASM, B01_mock.SLDASM, B01_slip_mount.SLDPRT]
2015-09-18 Tidy up references for block
    [B01_block.SLDPRT, B01_block_fix.SLDPRT, B01_block_lid.SLDPRT, B01_block_ref.SLDPRT, B01_lens.SLDASM, B01_mock.SLDASM, B01_slip_plate.SLDPRT, grating_sub.SLDASM]
2015-09-18 Update checkup with Ross (technician)
    [B01_mock.SLDASM]
2015-09-18 tidy up cad
    [B01_block_lid.SLDPRT, B01_mock.SLDASM]
2015-09-21 Create bill of materials
    [bom.xlsx]
2015-09-21 Update bom
    [bom.xlsx]
2015-09-21 Update part selection and create design D01
    [B01_block.SLDPRT, B01_mock.SLDASM, D01.SLDASM, WW11050-C14-Solidworks.sldprt, bom.xlsx]
2015-09-21 Update gain chip fiber connector dimensions
    [B01_gainchip.SLDASM, B01_gainchip_mount.SLDPRT, B01_mock.SLDASM, gainchip.SLDPRT]
2015-09-21 Create D02 - polaris diff mount
    [D01.SLDASM, D02.SLDASM, LM05XY_M-Solidworks.sldprt, POLARIS-K05-Solidworks.sldprt, grating_sub.SLDASM, polaris_grating_sub.SLDASM]
2015-09-22 collimating lens evaluation
    [B01_lens.SLDASM, B01_mock.SLDASM, C230TME-1064-Solidworks.sldprt, bom.xlsx]
2015-09-22 add f=8 NA=0.5 lens
    [C240TME-1064-Solidworks.sldprt]
2015-09-22 add lens mount cad and drawings
2015-09-22 Update bom and design log
    [bom.xlsx]
2015-09-24 Create B02: integrated block design
    [B01_block_02.SLDPRT, B01_block_lid_02.SLDPRT, B01_gainchip_02.SLDASM, B01_gainchip_mount_02.SLDPRT, B01_lens_02.SLDASM, B01_slip_plate_02.SLDPRT, B02.SLDASM, GR13-1210-Solidworks_02.sldprt]
2015-09-24 Update log on B02 lens configs
    [B02.SLDASM, C230TME-1064-Solidworks.sldprt]
2015-09-24 Add collimating lens
    [B02.SLDASM, C240TME-1064-Solidworks.sldprt, bom.xlsx]
2015-09-24 Grating positioning and lens mount
    [B01_block_02.SLDPRT, B01_block_lid_02.SLDPRT, B02.SLDASM, C240TME-1064-Solidworks.sldprt, bom.xlsx, grating_sub_02.SLDASM]
2015-09-25 update cad and todos
    [B01_block_02.SLDPRT, B01_block_lid_02.SLDPRT, B01_gainchip.SLDASM, B01_gainchip_mount.SLDPRT, B01_mock.SLDASM, B02.SLDASM, WW11050-C14-Solidworks_02.sldprt, bom.xlsx]
2015-09-25 update ecdl b02 and todo list
    [B01_block_02.SLDPRT, B01_block_lid_02.SLDPRT, B02.SLDASM, gainchip_02.SLDPRT]
2015-09-26 Update gainchip CAD and todos
    [B01_block_02.SLDPRT, B01_block_lid_02.SLDPRT, B02.SLDASM, gainchip_02.SLDPRT]
2015-09-26 conceptual ecdl casing and block mounting
    [B01_block_02.SLDPRT, B01_block_lid_02.SLDPRT, B02.SLDASM, GR13-1210-Solidworks_02.sldprt, PCh150-10x10-2.SLDPRT, grating_sub_02.SLDASM]
2015-09-28 add ideas for fiber cable grip @ block, fiber chuck @ casing, thermistor hole, etc
    [B01_block_02.SLDPRT, B02.SLDASM, FPH-SR.SLDPRT, bare_fiber_chuck.SLDASM]
2015-09-28 Add recess to block and base for TEC
    [B01_block_02.SLDPRT, B02.SLDASM]
2015-09-28 rebuild B02 assembly
    [B02.SLDASM]
2015-09-28 B03 design with integrated mount for gainchip and collimator
    [B03.SLDASM, B03_B01_block_02.SLDPRT, B03_C240TME-1064-Solidworks.sldprt, B03_GR13-1210-Solidworks_02.sldprt, B03_KMSS_M-Solidworks_1_02.SLDPRT, B03_PCh150-10x10-2.SLDPRT, B03_WW11050-C14-Solidworks_02.sldprt, B03_gainchip_02.SLDPRT]
2015-09-29 Add locating recess on GM mount - B03 seleted as final design
    [B01_block_02.SLDPRT, B02.SLDASM, B03.SLDASM, B03_B01_block_02.SLDPRT, bom.xlsx]
2015-09-30 Create final ecdl asm for drawing files
    [B03.SLDASM, B03_B01_block_02.SLDPRT, ecdl.SLDASM, gainchip_mount.SLDDRW, gainchip_mount.SLDPRT, lens_tube^ecdl.SLDDRW, lens_tube^ecdl.sldprt]
2015-09-30 create more drawings and update log
    [B03_B01_block_02.SLDDRW, B03_B01_block_02.SLDPRT, ecdl.SLDASM]
2015-09-30 Create pdfs for review
    [gainchip_mount.SLDDRW]
2015-09-30 Update tolerances in lens tube drw
    [ecdl.SLDASM, lens_tube^ecdl.SLDDRW]
2015-10-01 refine design and drawing dims
    [B03_B01_block_02.SLDDRW, B03_B01_block_02.SLDPRT, B03_grating_sub_02.SLDASM, ecdl.SLDASM, gainchip_mount.SLDDRW, gainchip_mount.SLDPRT, lens_tube^ecdl.SLDDRW]
2015-10-01 Create drawing for lid
    [block lid^ecdl.sldprt, block_lid.SLDDRW]
2015-10-02 changes for fabrication
    [B03_B01_block_02.SLDDRW, B03_B01_block_02.SLDPRT, B03_grating_sub_02.SLDASM, ecdl.SLDASM, ecdl_block.SLDDRW, ecdl_block.SLDPRT, gainchip_mount.SLDDRW]
2015-10-09 Update ordering jobs and todos
    [FSR1-Solidworks.sldprt]
2015-10-12 selected peltier, thermistor; cads for outsourcing
    [FSR1-Solidworks.sldprt, ecdl.SLDASM, main_block.SLDPRT, main_block.STEP]
2015-10-12 Unsuppressed CNC ready CAD; elec connector library
    [62GB-12E14-19PN.SLDPRT, main_block_all.SLDPRT, main_block_all.STEP]
2015-10-13 62GB 12pin connector at block
    [62GB-12E14-12PN.SLDPRT, 62GB-12E14-19PN.SLDPRT, ecdl.SLDASM, ecdl_block.SLDPRT]
2015-10-13 Select best circ elec connect for block
    [62GB-12E14-12PN(416).SLDPRT, ecdl.SLDASM]
2015-10-13 select peltier cooler (small) and assemble
    [APH-127-10-20-S.SLDPRT, ecdl.SLDASM]
2015-10-13 choose peltier, thermistor locations
    [APH-127-10-25-S.SLDPRT, ecdl.SLDASM, ecdl_block.SLDPRT]
2015-10-14 Finish fibre cable grip (slotted plug) for manufacturing
    [ecdl.SLDASM, ecdl_block.SLDPRT, fibre_cable_grip^ecdl.SLDDRW, fibre_cable_grip^ecdl.sldprt]
2015-10-20 block cad convert to mastercam compatibles
    [FSR1-Solidworks.sldprt, ecdl_block_rev.SLDPRT, ecdl_block_rev.STEP, ecdl_block_sent.SLDPRT, ecdl_block_sent.STEP]
2015-10-20 create fsr and modify housing
    [FSR1-Solidworks.sldprt, FSRmount.SLDPRT, ecdl.SLDASM, ecdl_block.SLDPRT, fibre_storage_reel.SLDPRT]
2015-10-20 crude implementation of 62GB connector
    [62GB-56T14-12SN(416)_env.SLDPRT, ecdl.SLDASM, ecdl_block.SLDPRT]
2015-10-21 Improve housing assembly, locating and mounting features
    [30080K1-Solidworks.sldprt, FSRmount.SLDDRW, FSRmount.SLDPRT, ecdl.SLDASM, ecdl_block.SLDPRT, fibre_cable_grip^ecdl.SLDDRW, fibre_cable_grip^ecdl.sldprt, fibre_storage_reel.SLDPRT]
2015-10-22 Add fiber connector on housing and arrange FSR
    [30080K1-Solidworks.sldprt, ADAFCPM2-Solidworks.sldprt, B03_grating_sub_02.SLDASM, FSRmount.SLDPRT, FSRmount_flat.SLDPRT, ecdl.SLDASM, fibre_storage_reel.SLDPRT, gainchip_mount_sent.SLDPRT]
